franciscoNSoria/Competencia-Robotica-CAID/docs/README.md

# Documentación

| Carpeta | Qué hay |
|---|---|
| [`reglamento/`](reglamento/) | Reglamento general (PDF) y transcripción del desafío "Laberinto inteligente" |
| [`roadmap/`](roadmap/) | El plan de trabajo por columnas, hitos y reglas de merge |
| [`guias/`](guias/) | Cómo hacer cosas: primeros pasos con el repo, entorno de desarrollo y GitHub Projects |
| [`decisiones/`](decisiones/) | Decisiones de arquitectura (ADR): qué decidimos y por qué |
| [`analisis/`](analisis/) | Análisis técnicos de apoyo (por ejemplo, el trabajo previo de navegación) |
| [`memoria/`](memoria/) | La memoria técnica, que se escribe sección por sección durante el proyecto |
