franciscoNSoria/Competencia-Robotica-CAID/docs/decisiones/plantilla.md

# NNNN. Título corto de la decisión

- **Estado:** Propuesta | Aceptada | Reemplazada por NNNN
- **Fecha:** AAAA-MM-DD

## Contexto

¿Qué problema hay que resolver? ¿Qué restricciones hay (reglamento, hardware, tiempo)?

## Decisión

Qué decidimos, en una o dos frases claras.

## Alternativas consideradas

- **Alternativa A:** por qué no.
- **Alternativa B:** por qué no.

## Consecuencias

Qué se vuelve más fácil, qué se vuelve más difícil y qué hay que hacer a partir de ahora.
