franciscoNSoria/Competencia-Robotica-CAID/docs/arquitectura/img/rviz_brazo.png

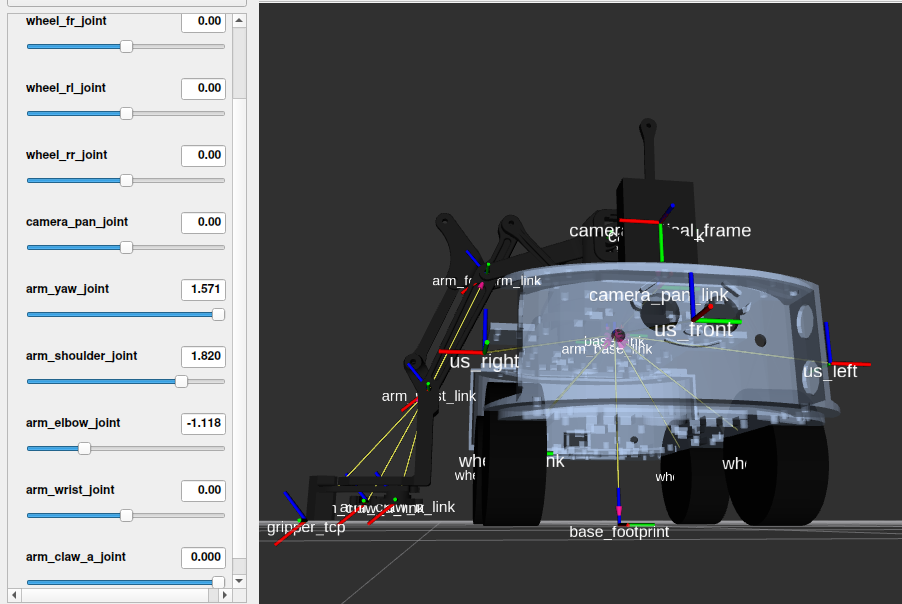
docs/arquitectura/img/rviz_brazo.png
