franciscoNSoria/Competencia-Robotica-CAID/docs/arquitectura/img/rviz_resposo.png

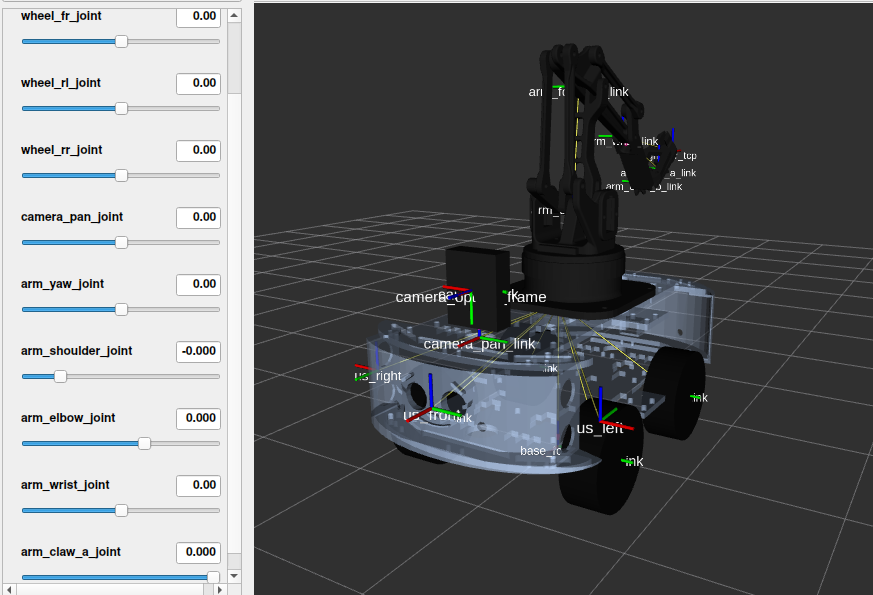
docs/arquitectura/img/rviz_resposo.png
