franciscoNSoria/Competencia-Robotica-CAID/firmware/pruebas/img/circuito_completo_pinout_actual.png

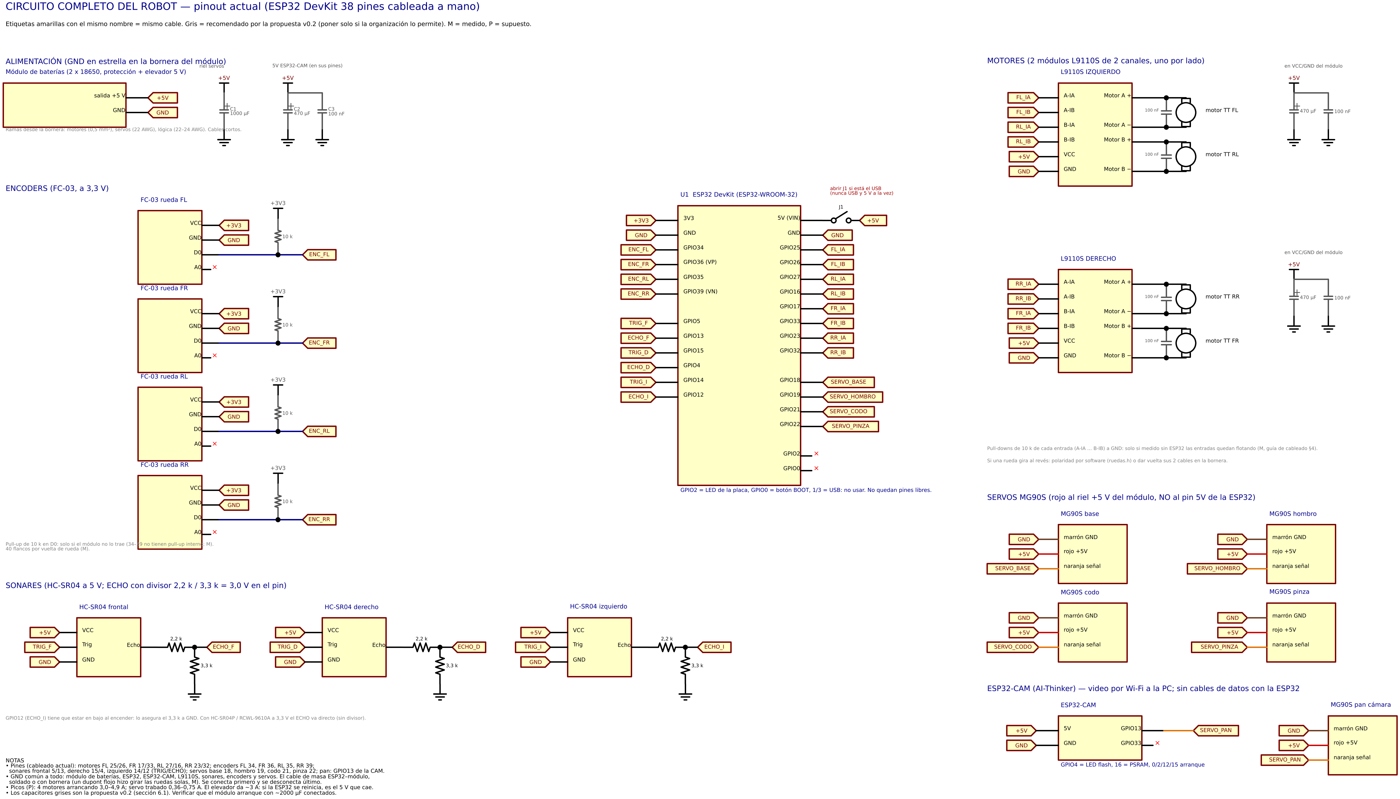
firmware/pruebas/img/circuito_completo_pinout_actual.png
