franciscoNSoria/Competencia-Robotica-CAID/hardware/electronica/placas/ConcentradorDelantero_esquematico_1.png

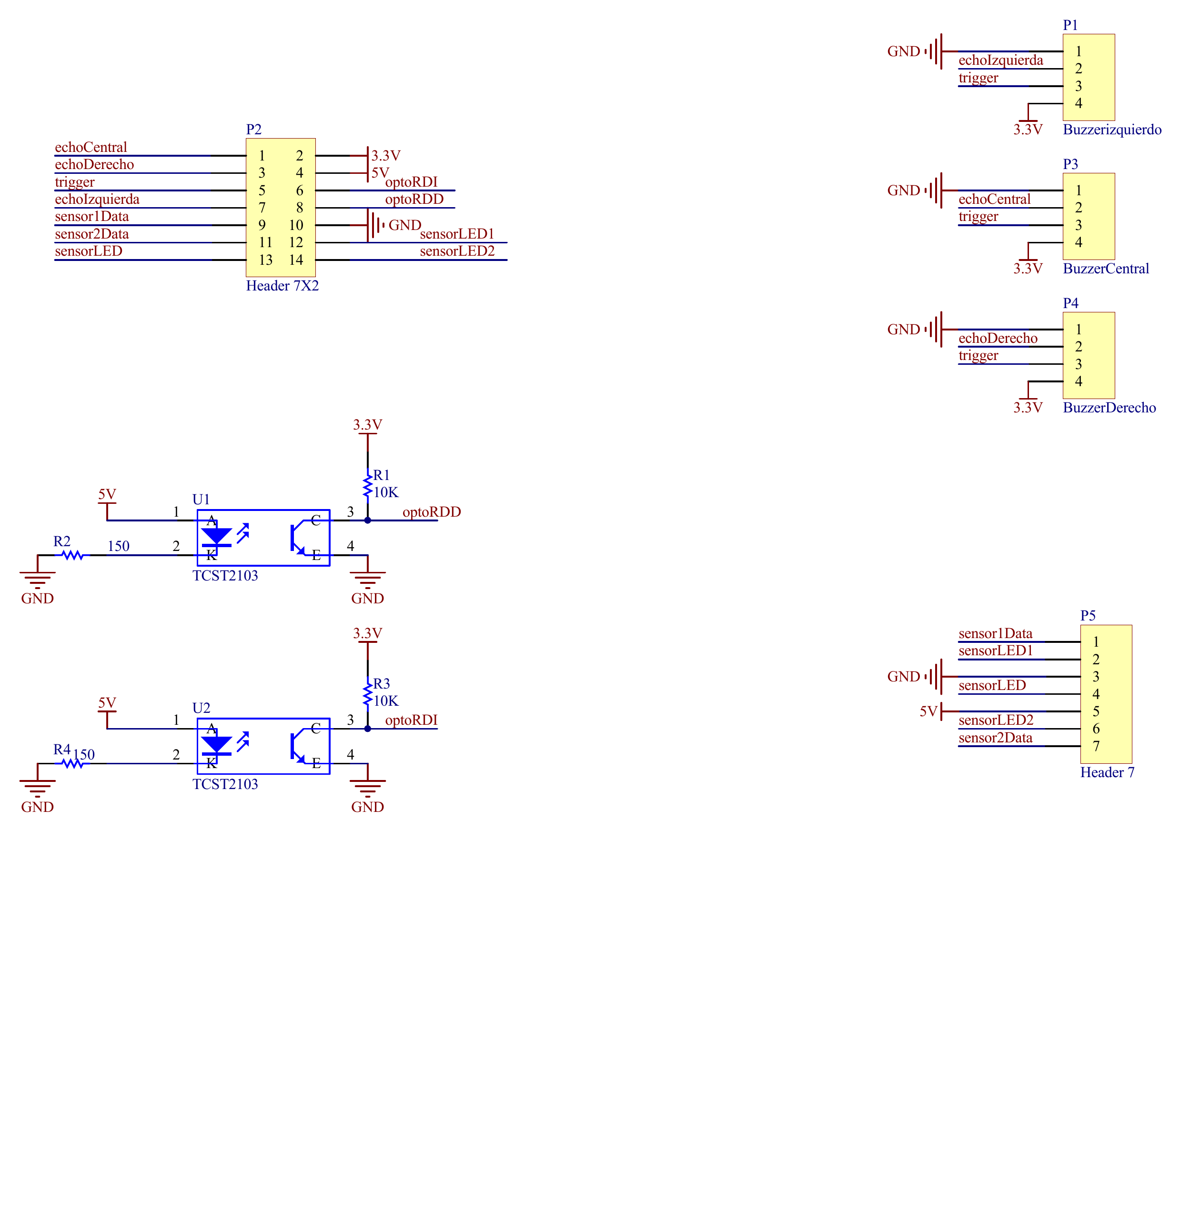
hardware/electronica/placas/ConcentradorDelantero_esquematico_1.png
