franciscoNSoria/Competencia-Robotica-CAID/hardware/electronica/placas/ConcentradorDelantero_pcb.png

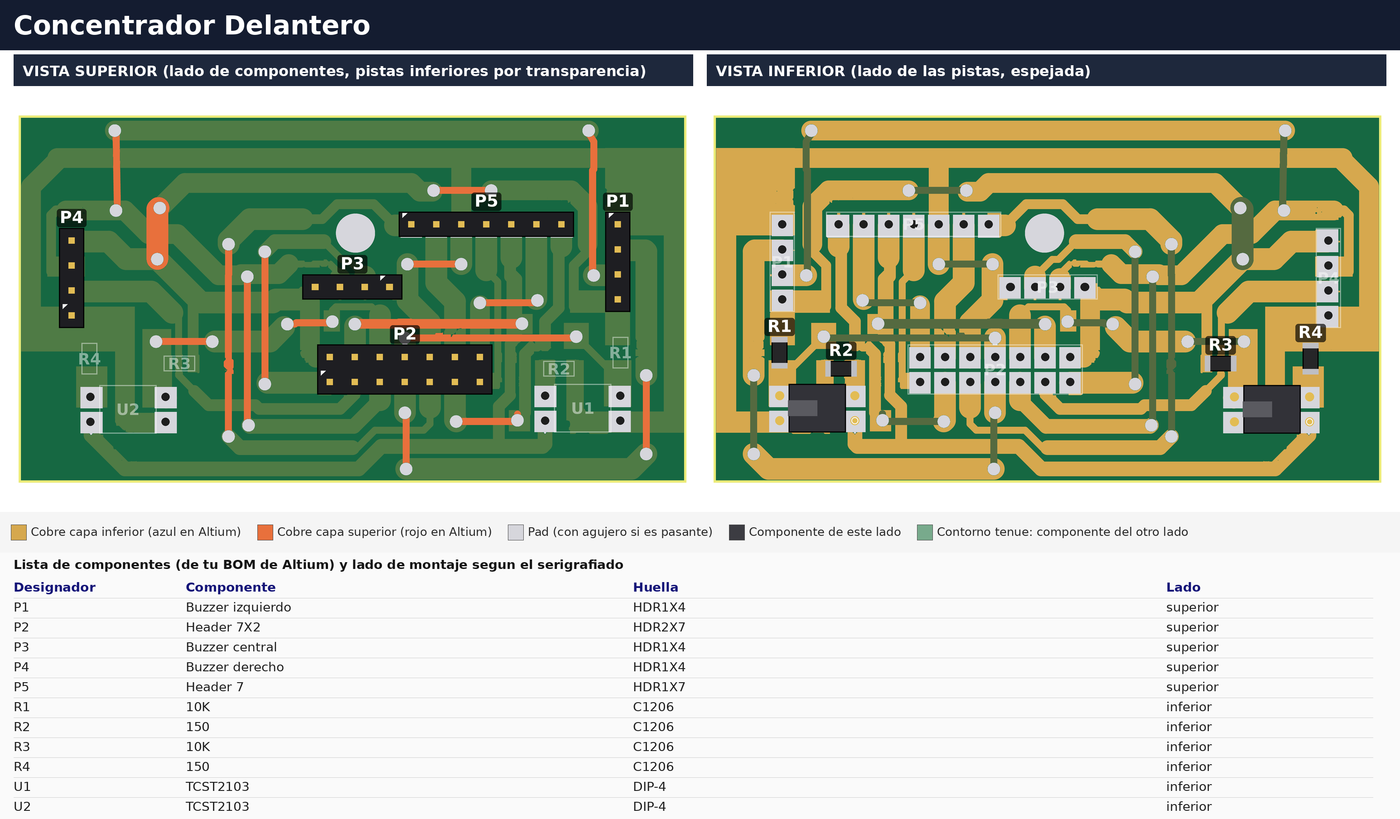
hardware/electronica/placas/ConcentradorDelantero_pcb.png
