franciscoNSoria/Competencia-Robotica-CAID/hardware/electronica/placas/ControlBrazo_esquematico_1.png

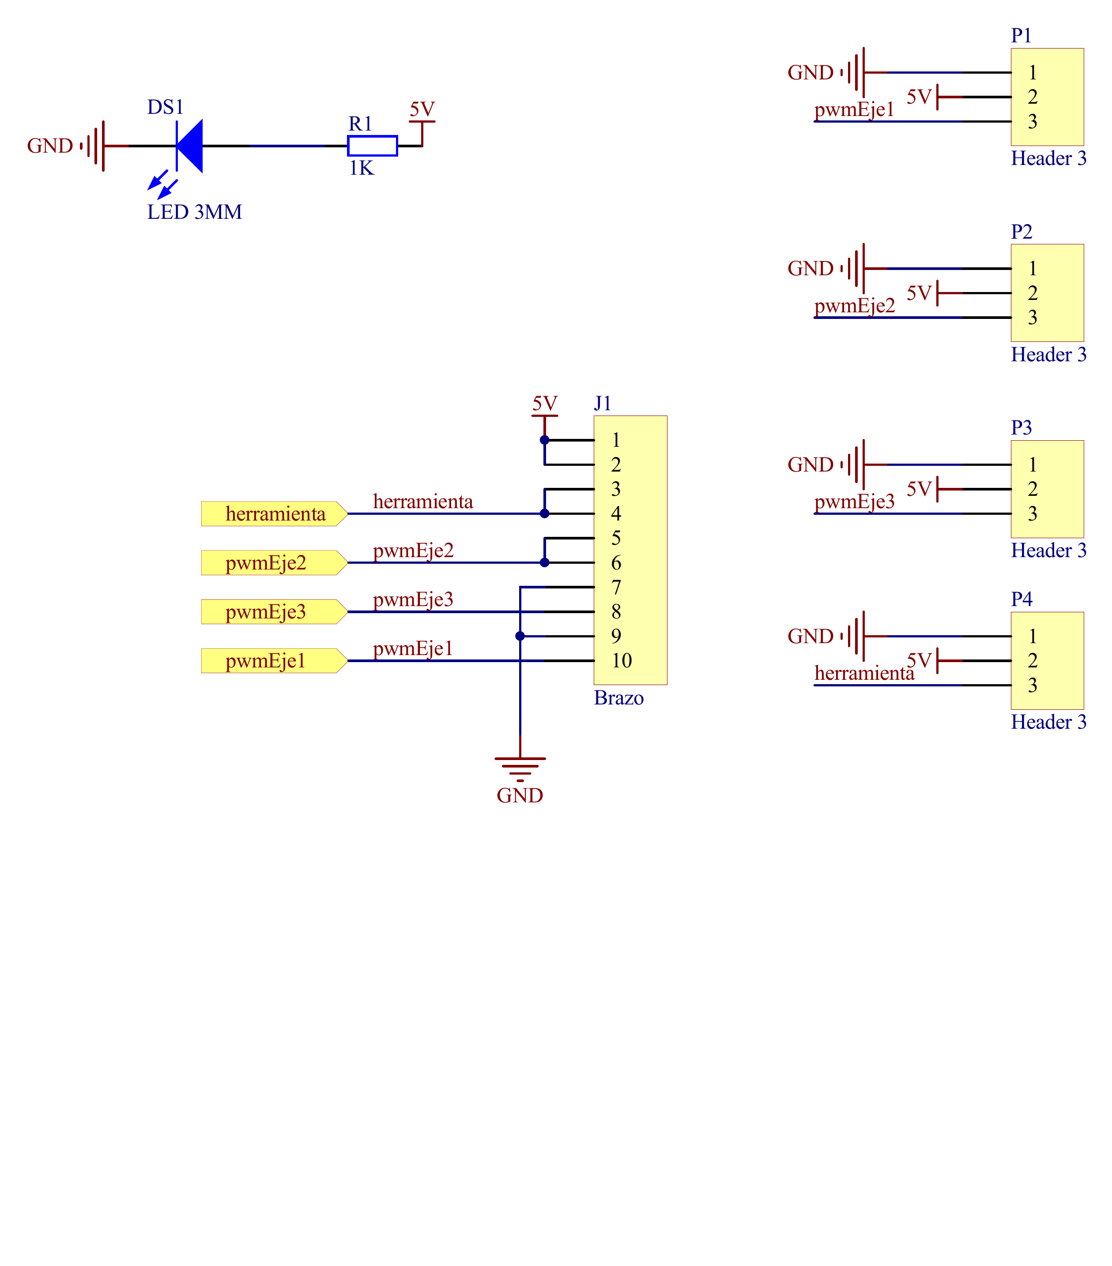
hardware/electronica/placas/ControlBrazo_esquematico_1.png
