franciscoNSoria/Competencia-Robotica-CAID/hardware/electronica/placas/ControlBrazo_pcb.png

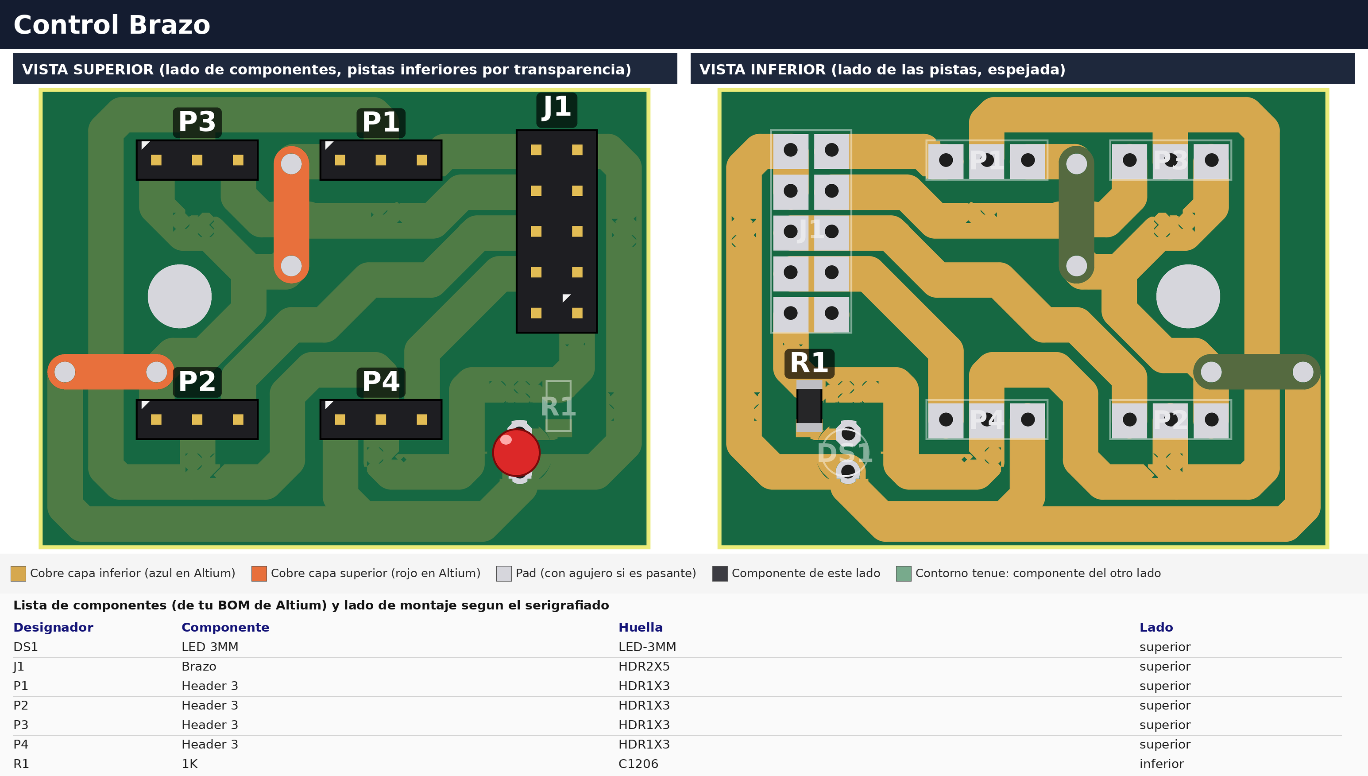
hardware/electronica/placas/ControlBrazo_pcb.png
