franciscoNSoria/Competencia-Robotica-CAID/hardware/electronica/placas/ControlRobot_esquematico_1.png

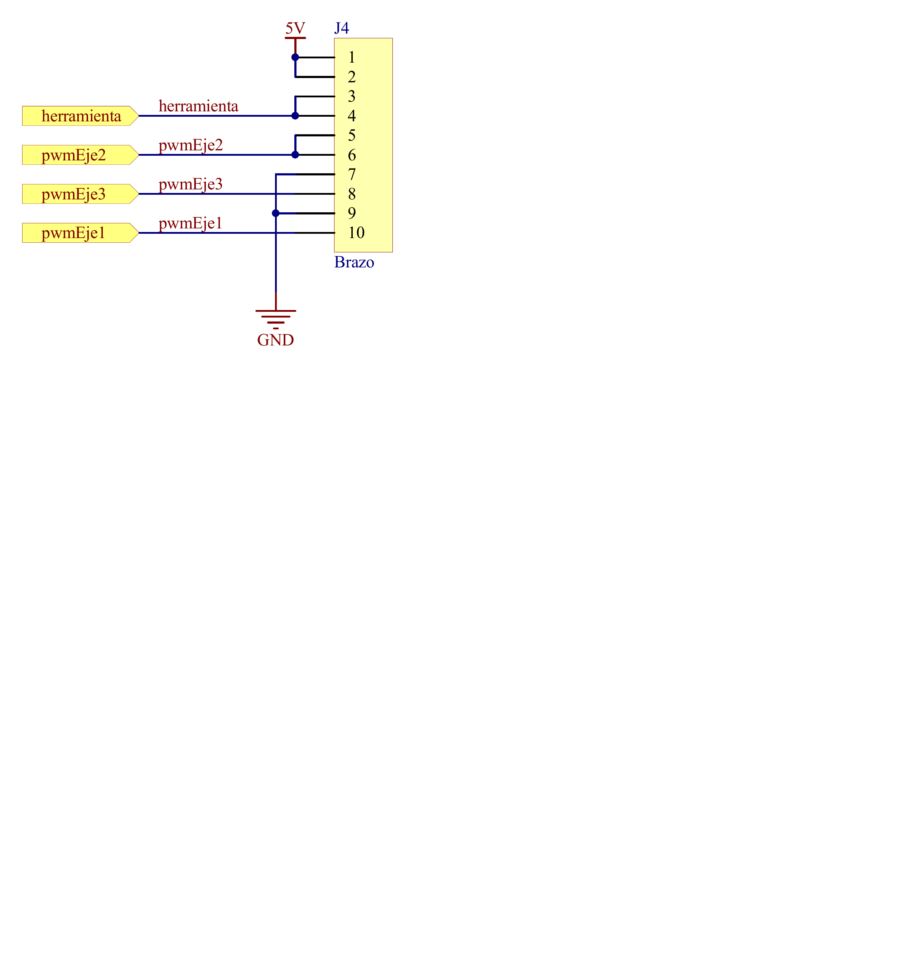
hardware/electronica/placas/ControlRobot_esquematico_1.png
