franciscoNSoria/Competencia-Robotica-CAID/hardware/electronica/placas/ControlRobot_esquematico_2.png

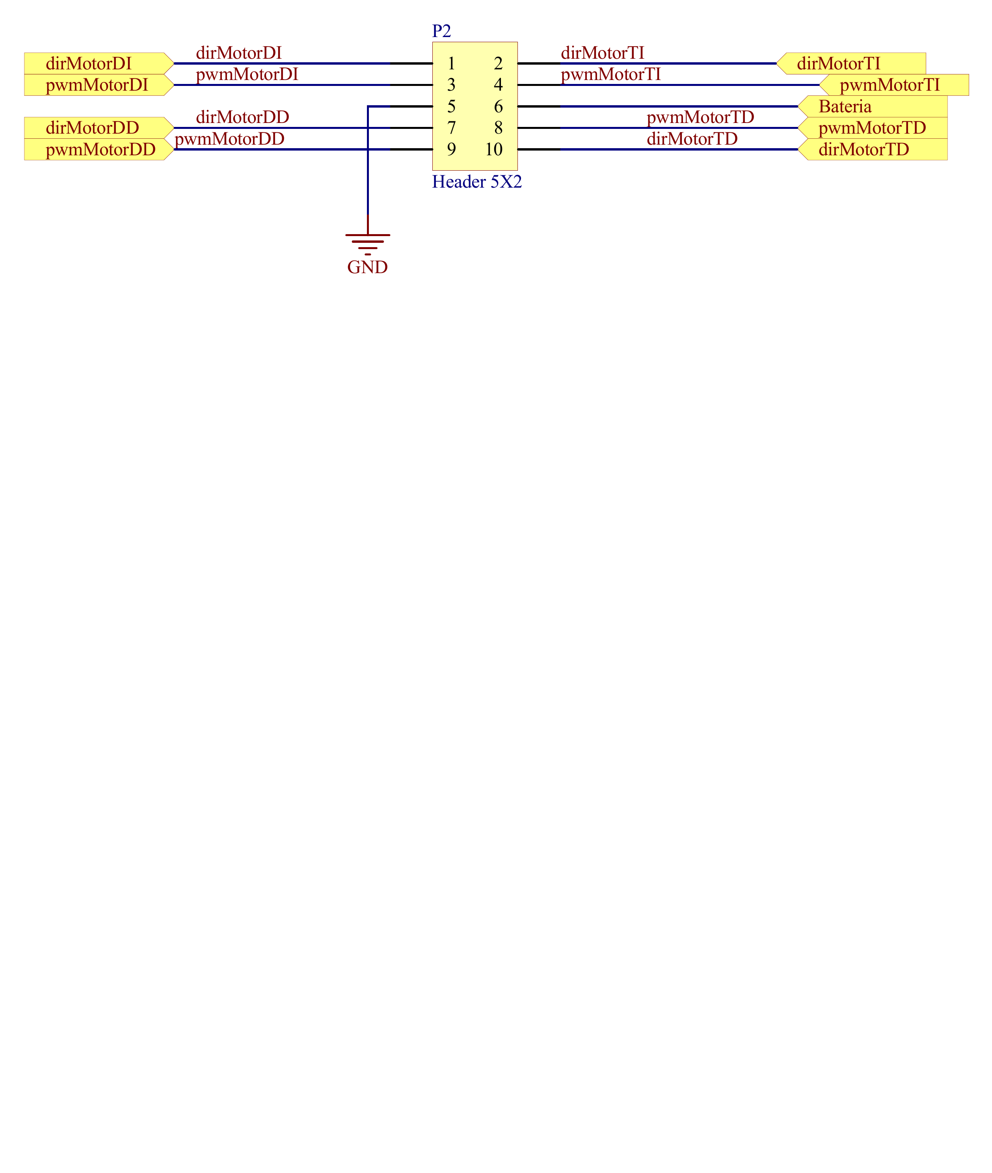
hardware/electronica/placas/ControlRobot_esquematico_2.png
