franciscoNSoria/Competencia-Robotica-CAID/hardware/electronica/placas/ControlRobot_esquematico_3.png

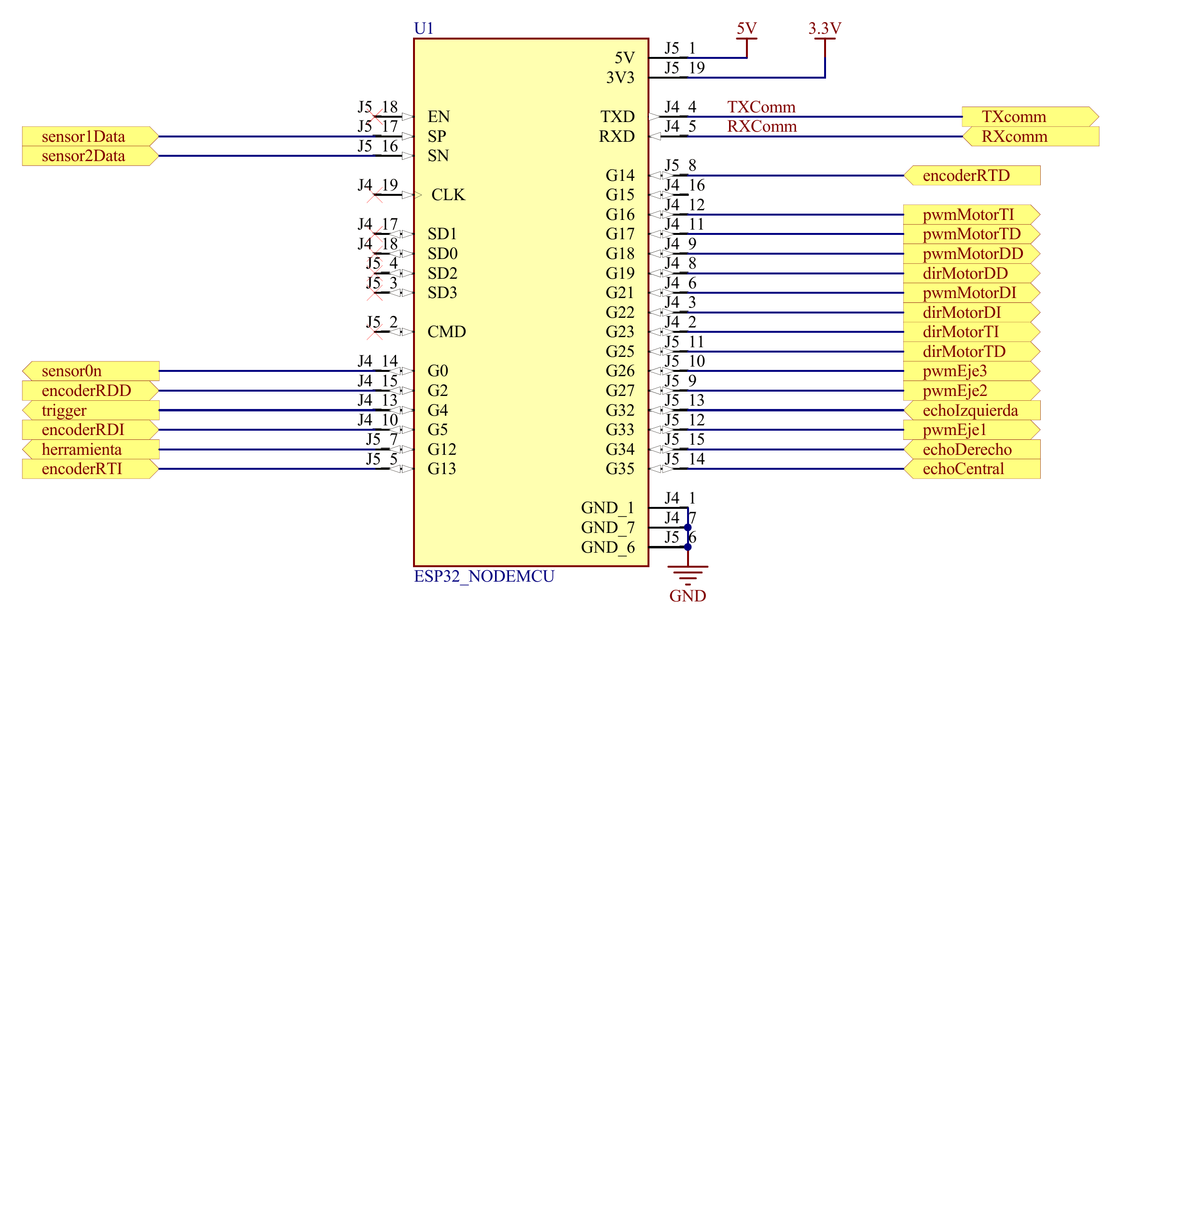
hardware/electronica/placas/ControlRobot_esquematico_3.png
