franciscoNSoria/Competencia-Robotica-CAID/hardware/electronica/placas/ControlRobot_esquematico_4.png

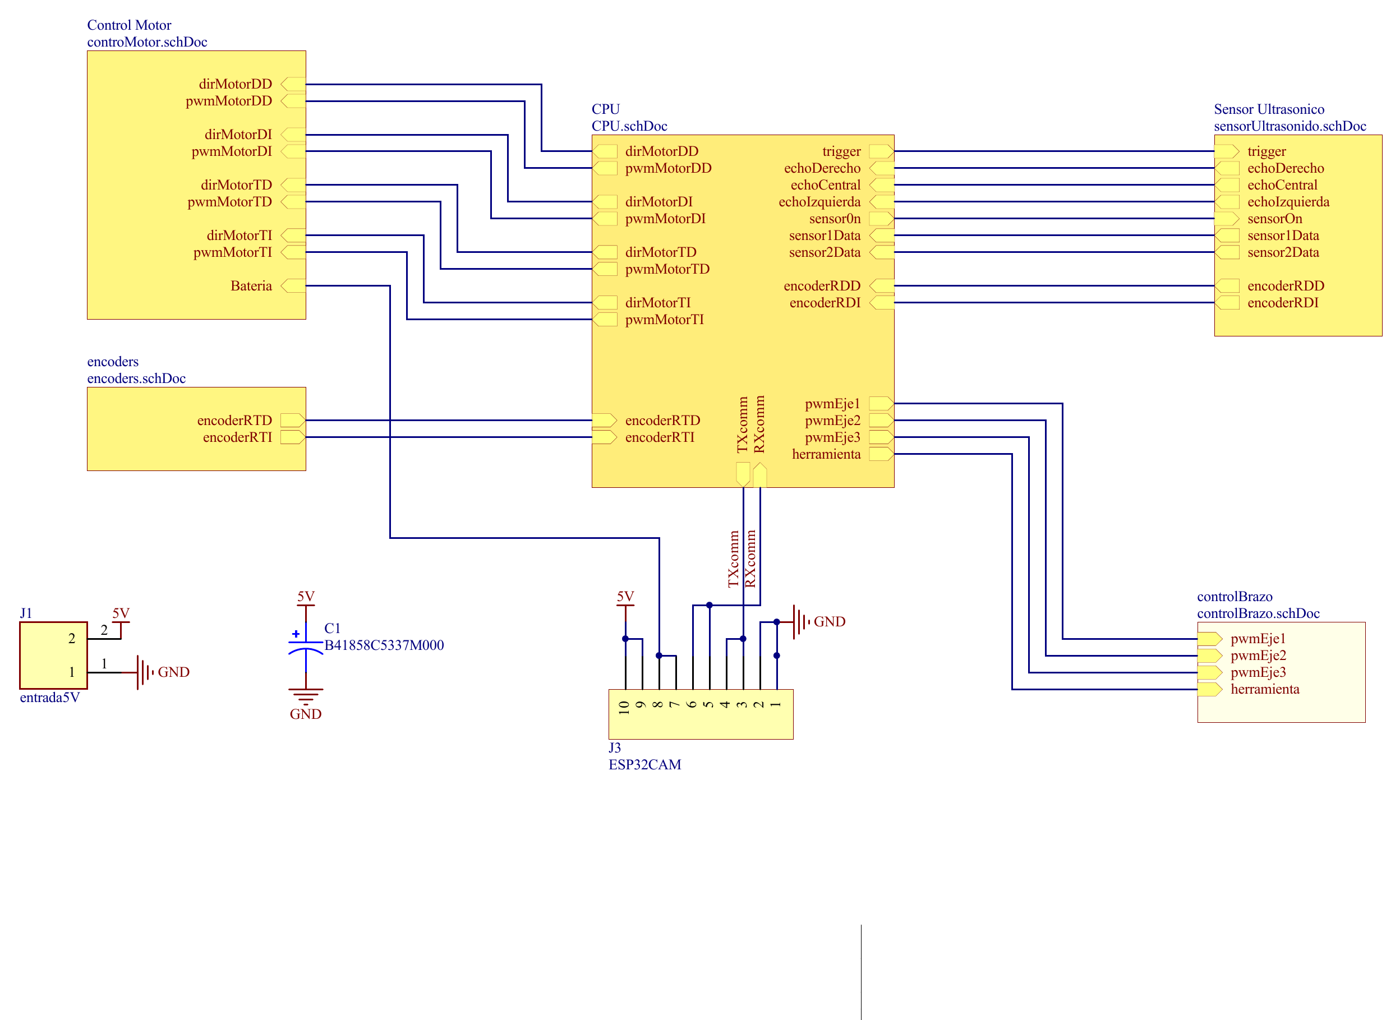
hardware/electronica/placas/ControlRobot_esquematico_4.png
