franciscoNSoria/Competencia-Robotica-CAID/hardware/electronica/placas/ControlRobot_esquematico_5.png

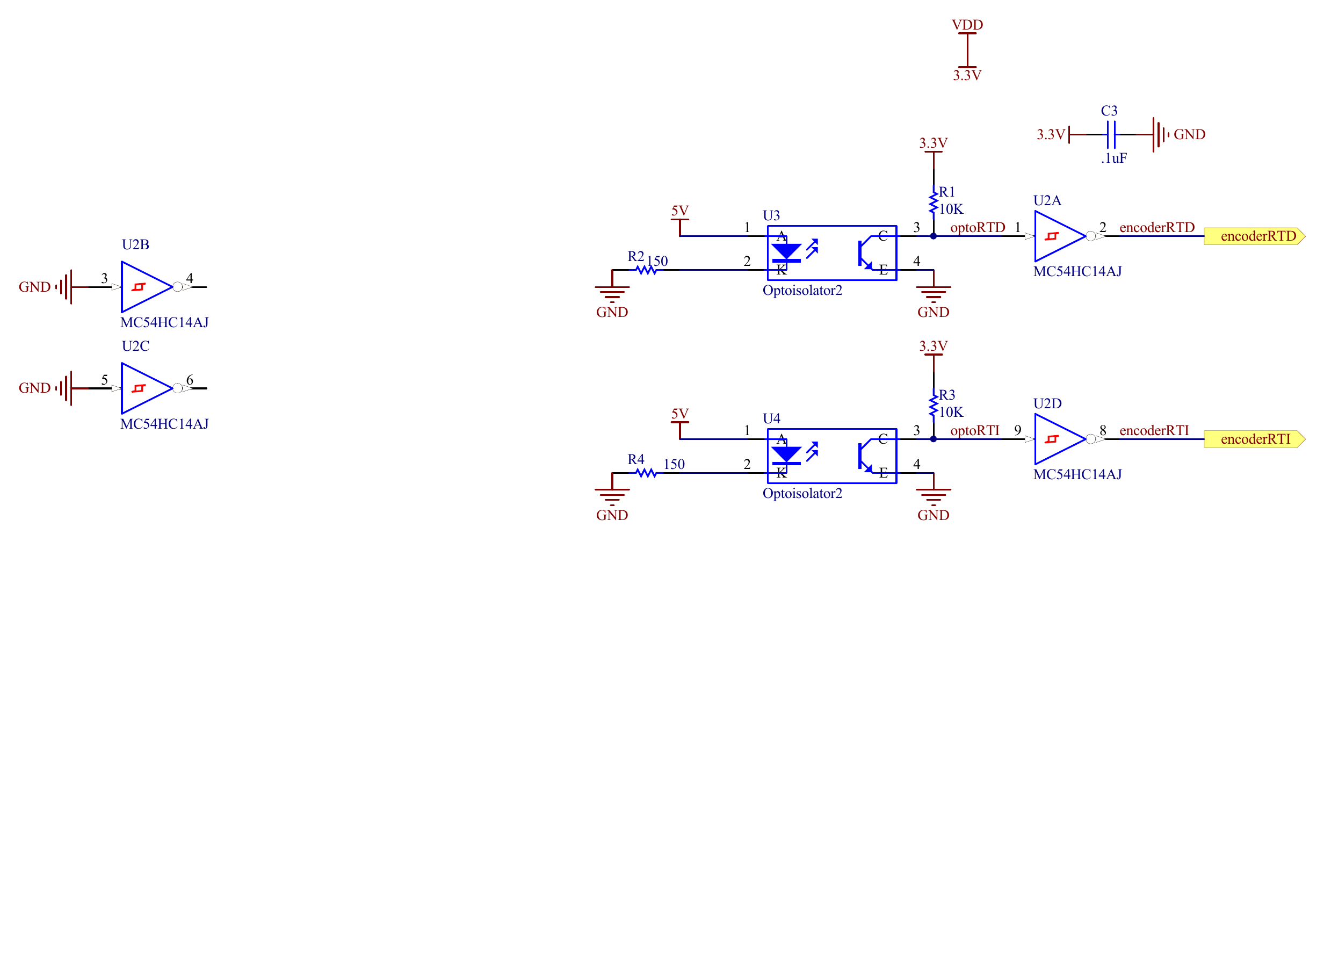
hardware/electronica/placas/ControlRobot_esquematico_5.png
