franciscoNSoria/Competencia-Robotica-CAID/hardware/electronica/placas/ControlRobot_esquematico_6.png

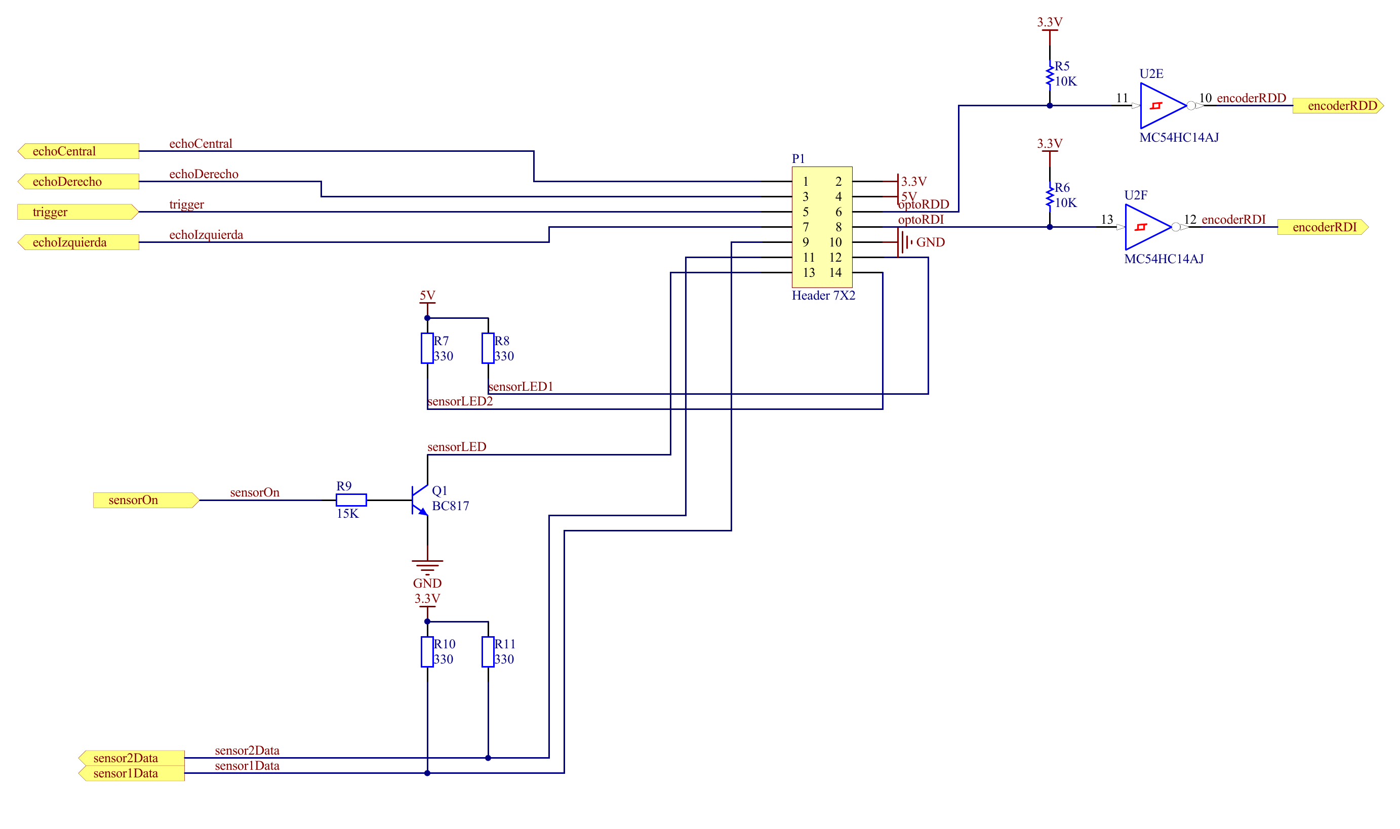
hardware/electronica/placas/ControlRobot_esquematico_6.png
