franciscoNSoria/Competencia-Robotica-CAID/hardware/electronica/placas/ControlRobot_pcb.png

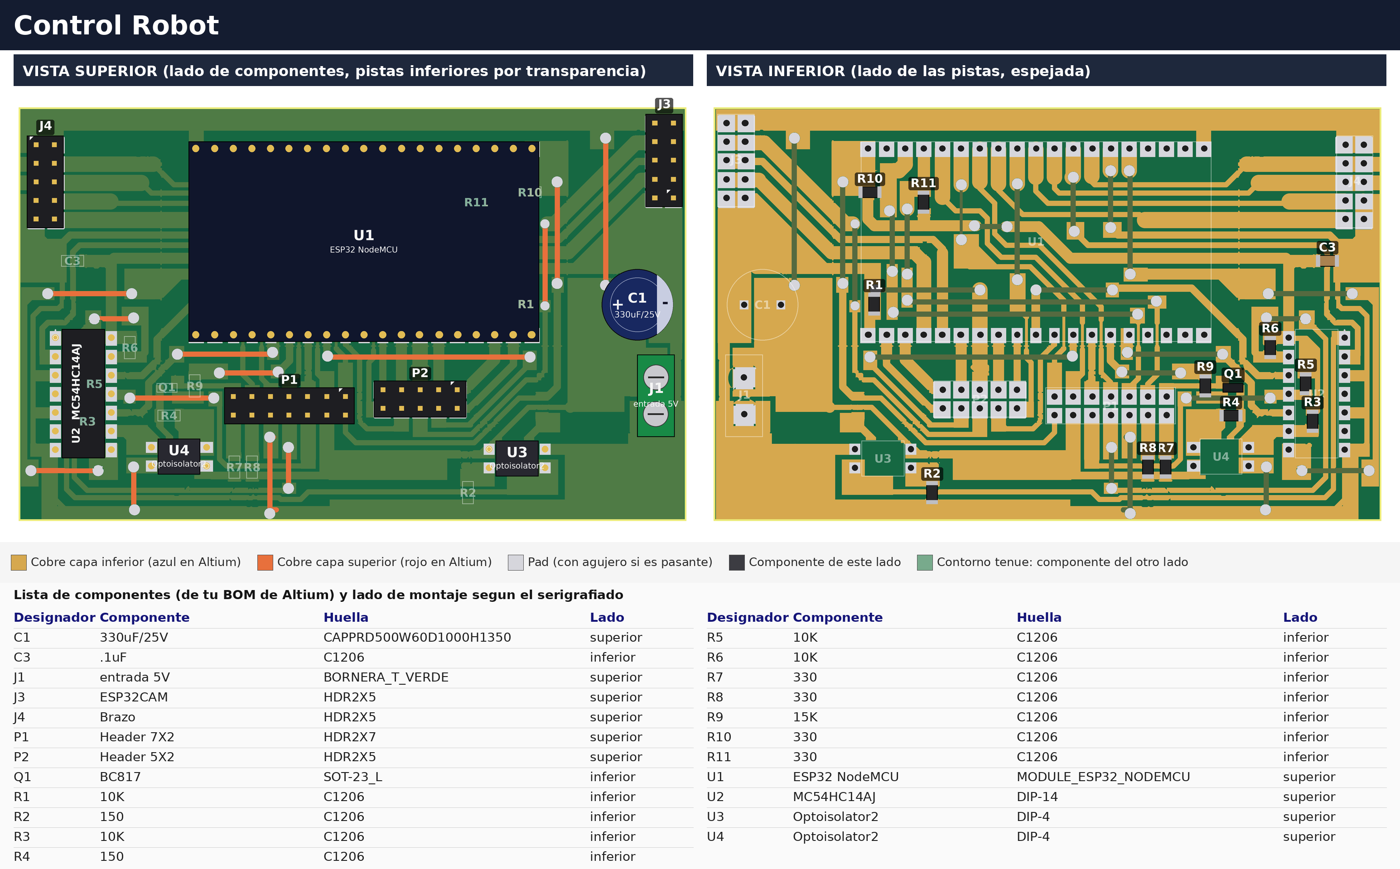
hardware/electronica/placas/ControlRobot_pcb.png
