franciscoNSoria/Competencia-Robotica-CAID/hardware/electronica/placas/ESP32CAM_esquematico_1.png

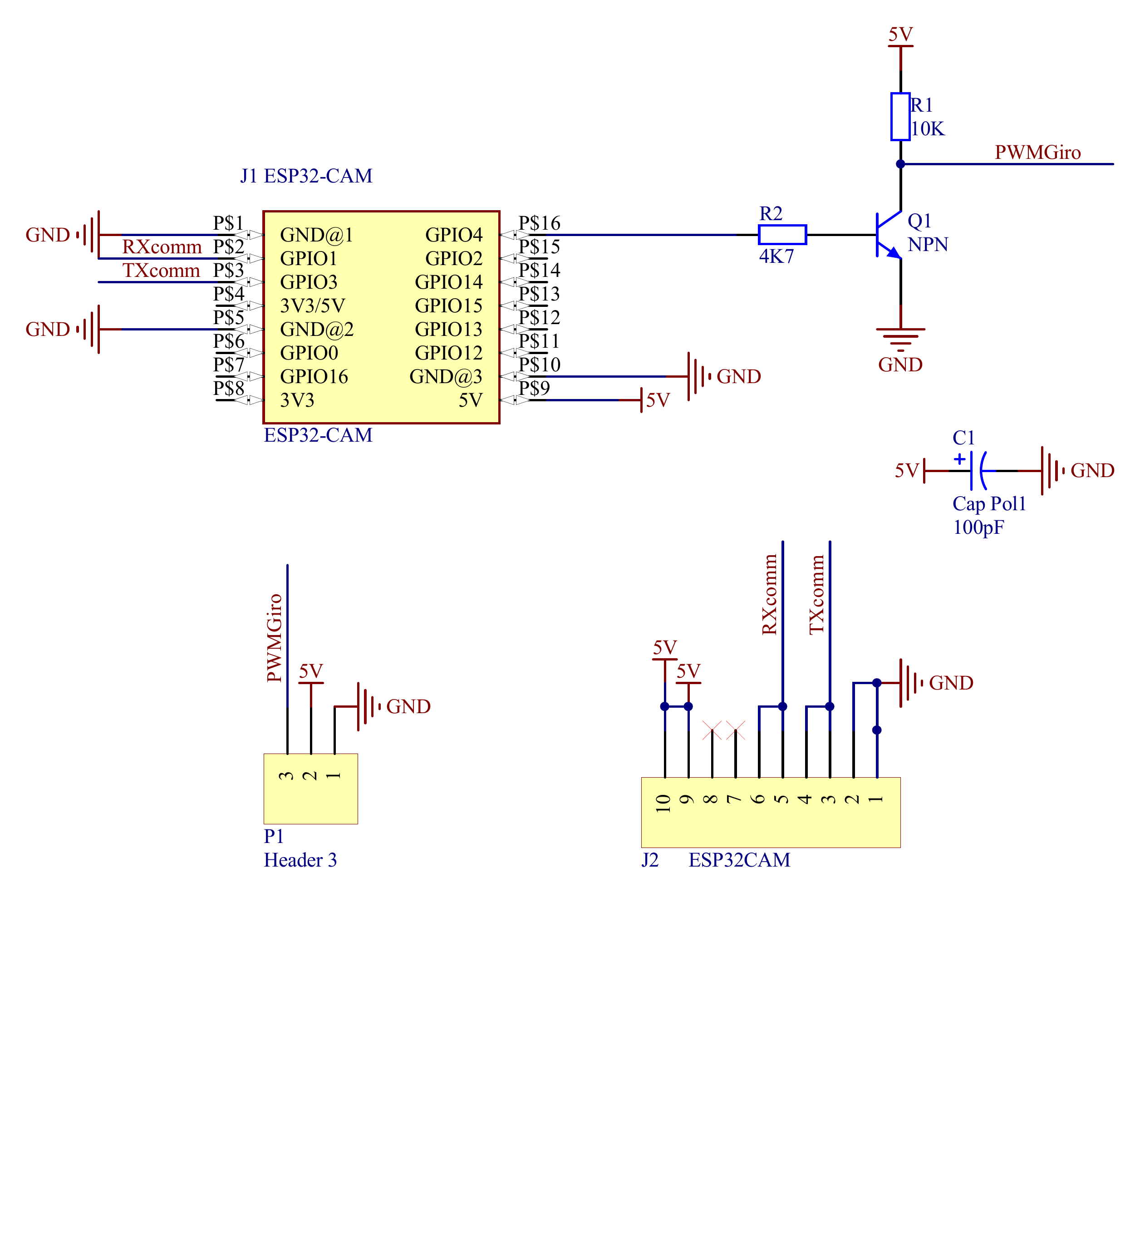
hardware/electronica/placas/ESP32CAM_esquematico_1.png
