franciscoNSoria/Competencia-Robotica-CAID/hardware/electronica/placas/ESP32CAM_pcb.png

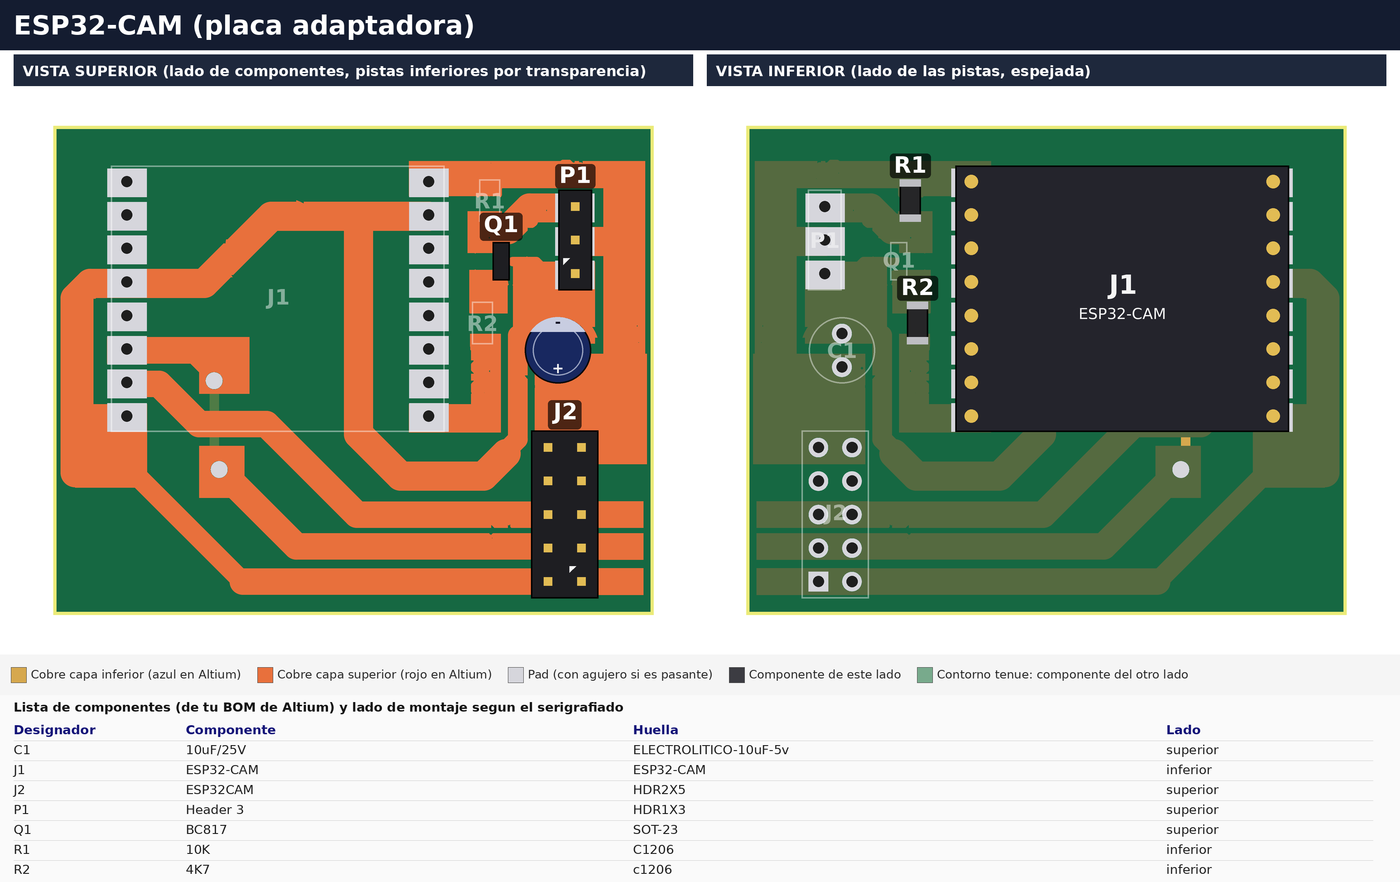
hardware/electronica/placas/ESP32CAM_pcb.png
