franciscoNSoria/Competencia-Robotica-CAID/hardware/electronica/placas/esquema_alimentacion_2S.png

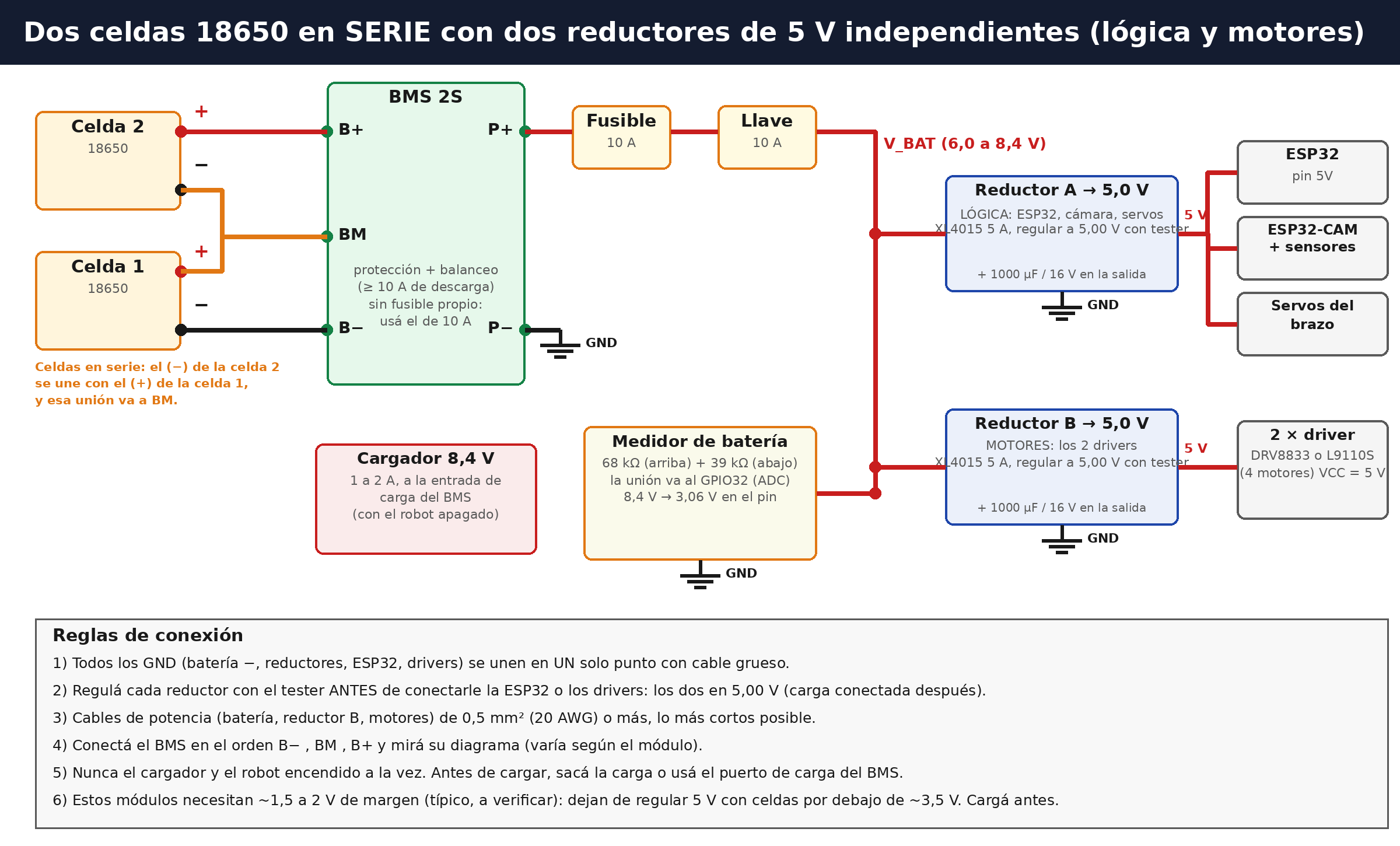
hardware/electronica/placas/esquema_alimentacion_2S.png
