franciscoNSoria/Competencia-Robotica-CAID/hardware/electronica/placas/PlacaMotor_esquematico_1.png

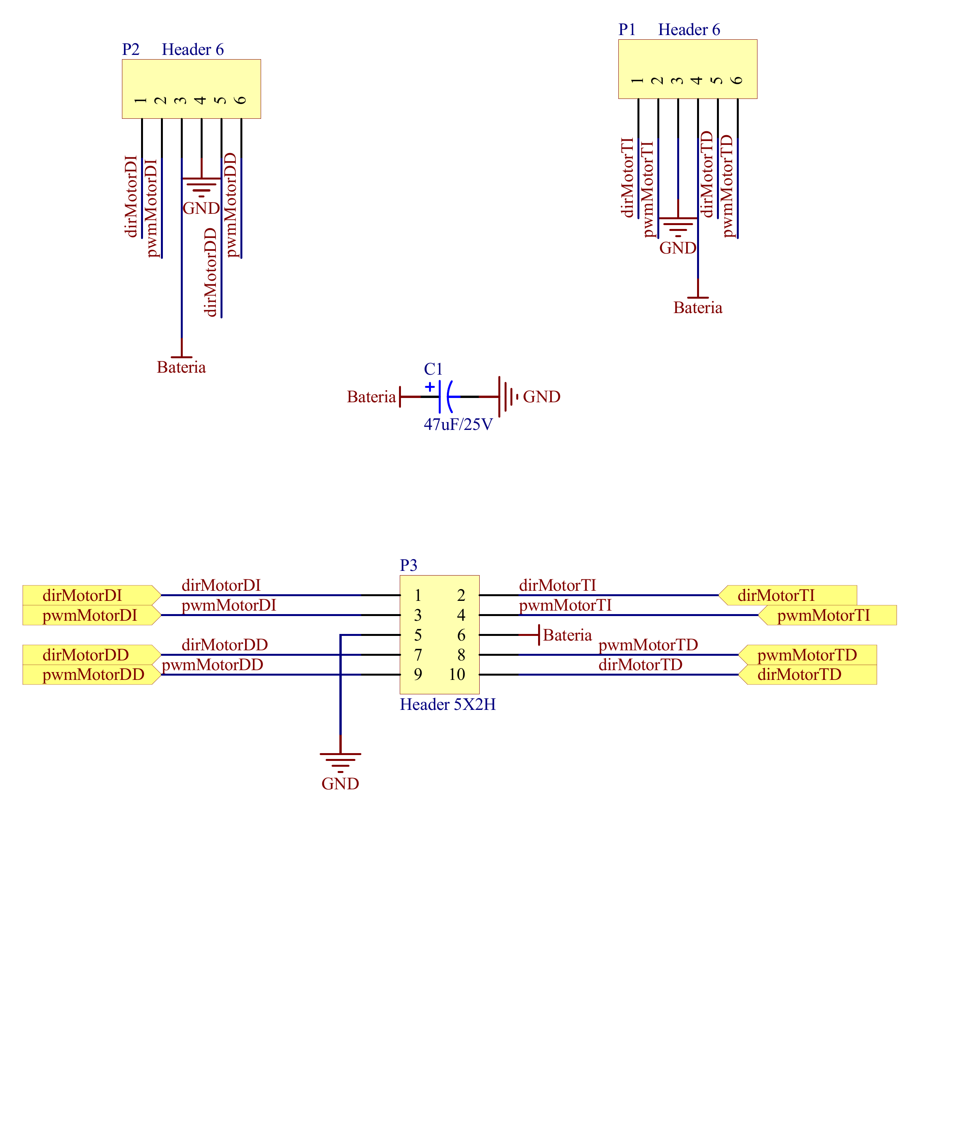
hardware/electronica/placas/PlacaMotor_esquematico_1.png
