franciscoNSoria/Competencia-Robotica-CAID/hardware/electronica/placas/PlacaMotor_pcb.png

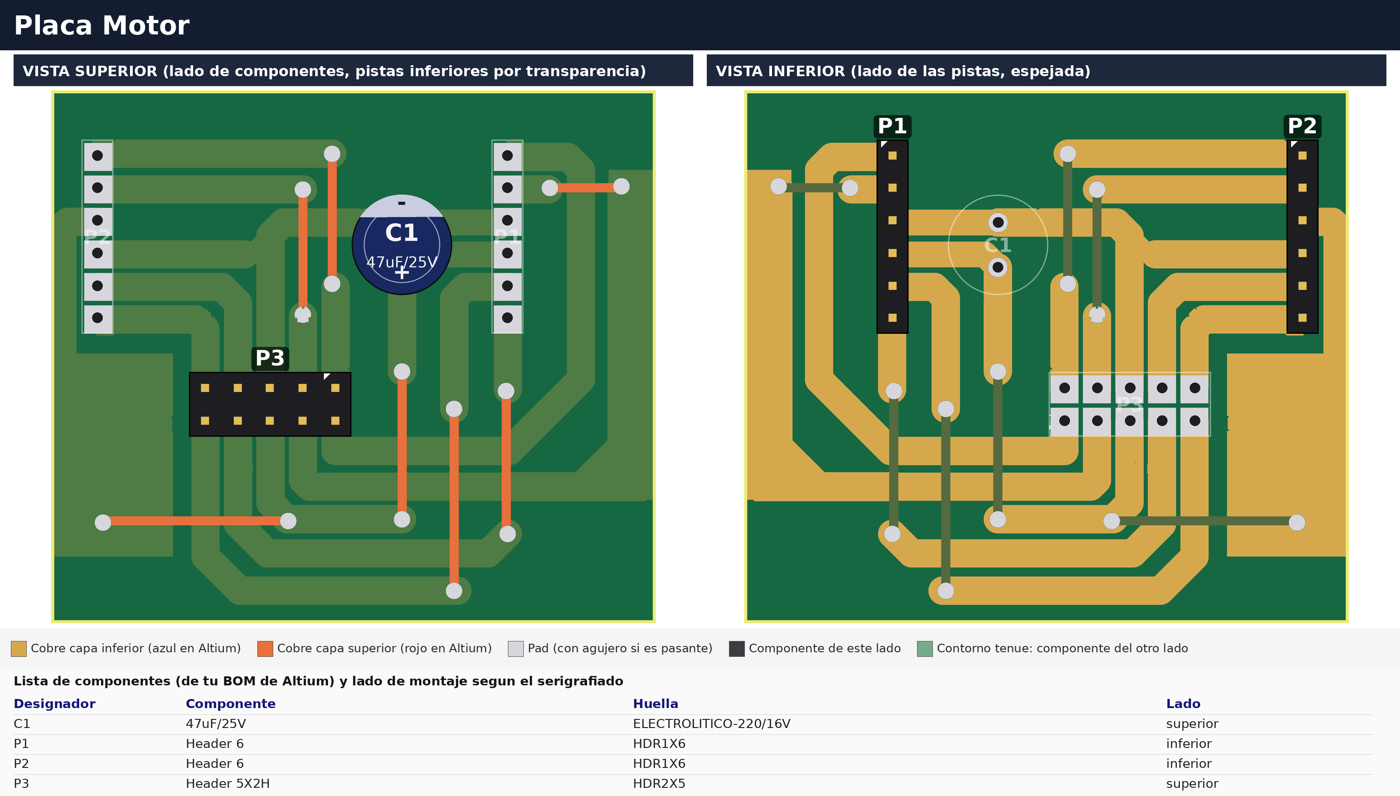
hardware/electronica/placas/PlacaMotor_pcb.png
