franciscoNSoria/Competencia-Robotica-CAID/hardware/bom/Lista_de_partes.ods

Conjunto | Subconjunto | Pieza | Descripción | Código | Cantidad | Peso unitario (g)
 |  |  |  |  |  |  | Codificación
Armadillo | Brazo |  | Base | ARM2-CUDAR-0-1-10 | 1 | 40 | Prefijo | Conjunto | Subconjunto | Numero de piezas
 |  |  |  |  |  |  | ARM2-CUDAR- | 0 Armadillo | 1 brazo | 10
 |  |  |  |  |  |  |  |  | 2 chasis | 10
 |  |  |  |  |  |  |  |  | 3 cámara | 4
 |  |  |  |  |  |  | ELEMENTOS |  | Cantidad
 |  |  |  |  |  |  | TORNILLOS | M3 x 40 | 1
 |  |  |  |  |  |  |  | M3 x 30 | 2
 |  |  |  |  |  |  |  | M3 x 25 | 11
 |  |  | Engranaje conductor | ARM2-CUDAR-0-1-20 | 1 | 1 |  | M3 x 20 | 10
 |  |  |  |  |  |  |  | M3 x 15 | 4
 |  |  |  |  |  |  | TUERCAS | M3 | 28
 |  |  |  |  |  |  | CHASIS | 4WD | 2
 |  |  |  |  |  |  | MOTOR-RUEDA | 4WD | 4
 |  |  |  |  |  |  | SERVOS | SG90 | 5
 |  |  | Soporte de garras | ARM2-CUDAR-0-1-30 | 1 | 11
 |  |  | Engranaje conducido | ARM2-CUDAR-0-1-40 | 1 | 1
 |  |  | Garra izquierda | ARM2-CUDAR-0-1-50 | 1 | 3
 |  |  | Garra derecha | ARM2-CUDAR-0-1-60 | 1 | 3
 |  |  | Brazo principal | ARM2-CUDAR-0-1-70 | 1 | 10
 |  |  | soporte de servo | ARM2-CUDAR-0-1-80 | 2 | 1
 |  |  | Soporte triangular | ARM2-CUDAR-0-1-90 | 1 | 4
 |  |  | Brazo superior | ARM2-CUDAR-0-1-100 | 1 | 7
 |  |  | Articulación | ARM2-CUDAR-0-1-110 | 3 | 3
 |  |  | Soporte principal | ARM2-CUDAR-0-1-120 | 1 | 19
 |  |  | Plato circular | ARM2-CUDAR-0-1-130 | 1 | 14
 |  |  | Brazo para servo | ARM2-CUDAR-0-1-140 | 1 | 3
 |  |  | Arandela de separación | ARM2-CUDAR-0-150 | 1 | 15
 | Chasis |  | Frente | ARM2-CUDAR-0-2-10 | 1 | 45
 |  |  | Posterior | ARM2-CUDAR-0-2-20 | 1 | 50
 |  |  | Lateral | ARM2-CUDAR-0-2-30 | 2 | 8
 |  |  | Tapa superior | ARM2-CUDAR-0-2-40 | 1 | 8
 |  |  | Tapas inferiores/superior trasera | ARM2-CUDAR-0-2-50 | 3 | 33
 |  |  | Soporte motores | ARM2-CUDAR-0-2-60 | 2 | 28
 | Cámara |  | Caja cámara frente | ARM2-CUDAR-0-3-10 | 1 | 5
 |  |  | Caja cámara posterior | ARM2-CUDAR-0-3-20 | 1 | 4
 |  |  | Unión cámara servo | ARM2-CUDAR-0-3-30 | 1 | 6
 |  |  | Soporte servo | ARM2-CUDAR-0-3-40 | 1 | 5
