franciscoNSoria/Competencia-Robotica-CAID/hardware/cad/ensamblado/Robot_armadillo_armado.stl

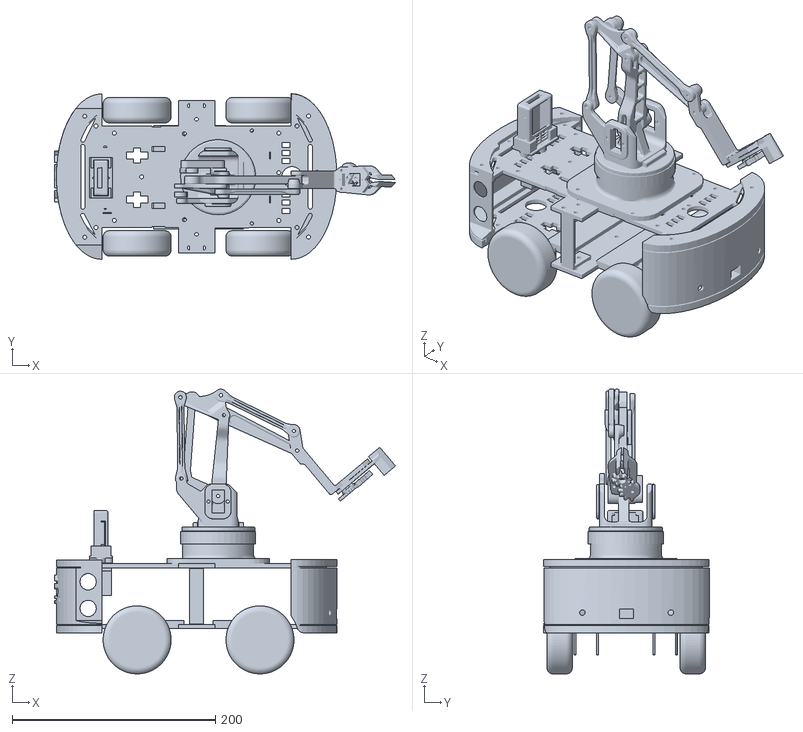
[picture p20: CAD file, 2026-10-19]
hardware/cad/ensamblado/Robot_armadillo_armado.stl
335.8 x 163.2 x 280.4
