franciscoNSoria/Competencia-Robotica-CAID/hardware/cad/Subconjunto-1-brazo/ARM2-CUDAR-0-1-140 Brazo principal.SLDPRT

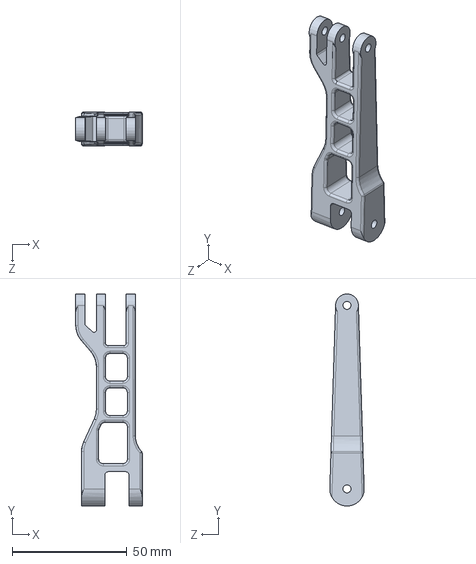
[picture p21: CAD file, 2026-10-15]
hardware/cad/Subconjunto-1-brazo/ARM2-CUDAR-0-1-140 Brazo principal.SLDPRT
29.0 x 92.4 x 15.0 mm
