franciscoNSoria/Competencia-Robotica-CAID/hardware/cad/Subconjunto-2-chasis/ARM2-CUDAR-0-2-10 .SLDPRT

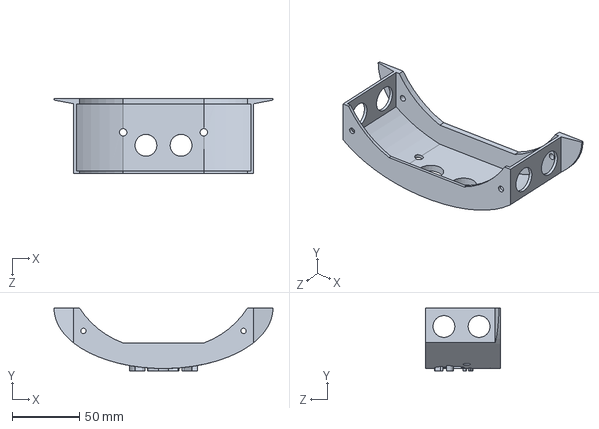
[picture p22: CAD file, 2026-10-15]
hardware/cad/Subconjunto-2-chasis/ARM2-CUDAR-0-2-10 .SLDPRT
163.0 x 46.9 x 56.0 mm
