franciscoNSoria/Competencia-Robotica-CAID/hardware/cad/Subconjunto-3-camara/ARM2-CUDAR-0-3-10.SLDPRT

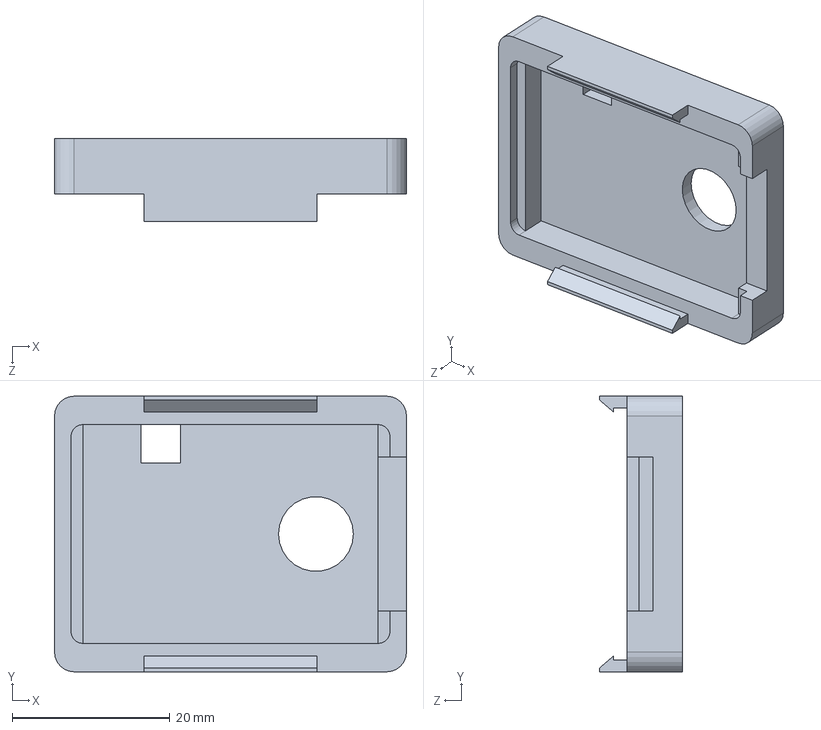
[picture p23: CAD file, 2026-10-15]
hardware/cad/Subconjunto-3-camara/ARM2-CUDAR-0-3-10.SLDPRT
44.7 x 35.0 x 10.5 mm
