franciscoNSoria/Competencia-Robotica-CAID/hardware/stl/Bloque de pared reglamentario.stl

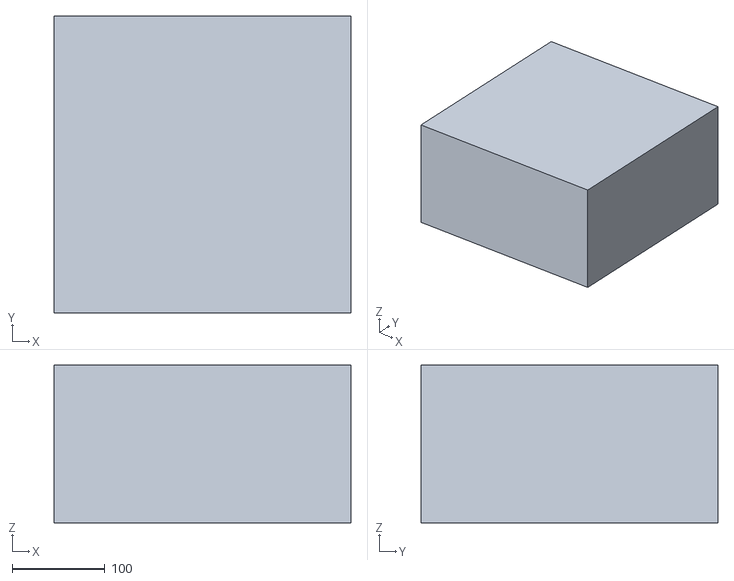
[picture p24: CAD file, 2026-10-28]
hardware/stl/Bloque de pared reglamentario.stl
320.0 x 320.0 x 170.0
