franciscoNSoria/Competencia-Robotica-CAID/ros2_ws/src/caid_description/meshes/arm/arm_wrist.stl

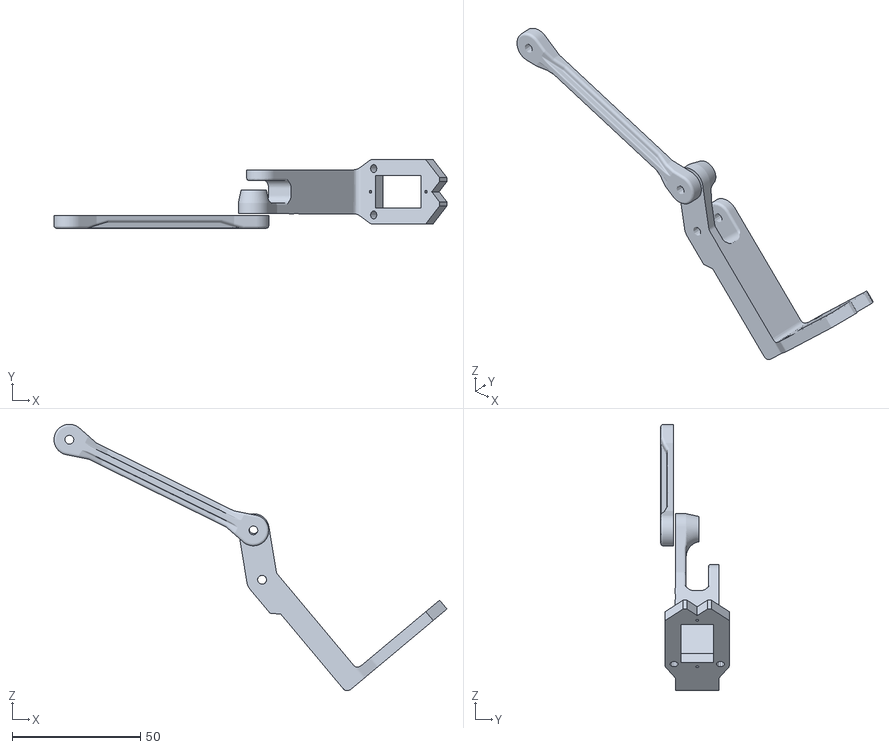
[picture p25: CAD file, 2026-10-19]
ros2_ws/src/caid_description/meshes/arm/arm_wrist.stl
153.2 x 26.7 x 103.9
