franciscoNSoria/Competencia-Robotica-CAID/ros2_ws/src/caid_description/meshes/pared_posterior.stl

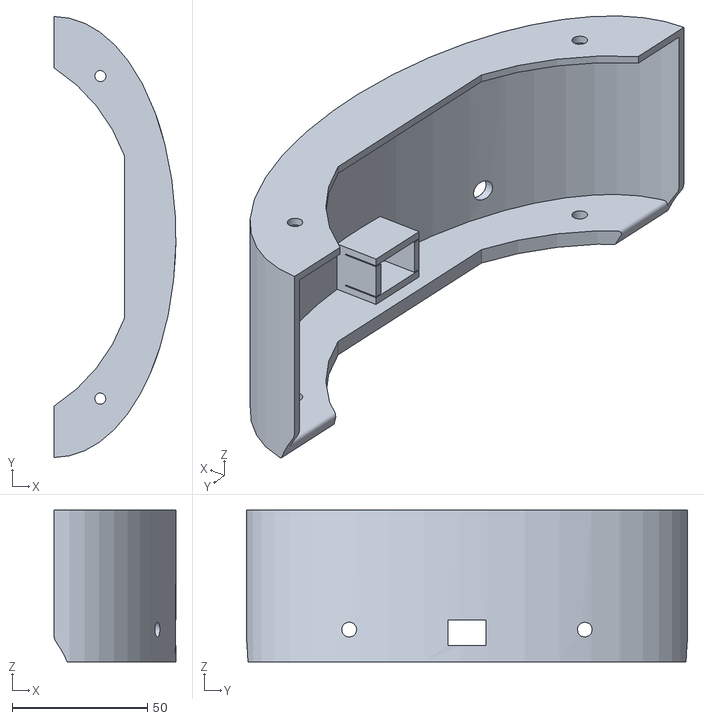
[picture p26: CAD file, 2026-10-19]
ros2_ws/src/caid_description/meshes/pared_posterior.stl
45.0 x 163.0 x 56.0
