franciscoNSoria/Competencia-Robotica-CAID/hardware/cad/Subconjunto-1-brazo/ARM2-CUDAR-0-1-80 Soporte de servo.SLDPRT

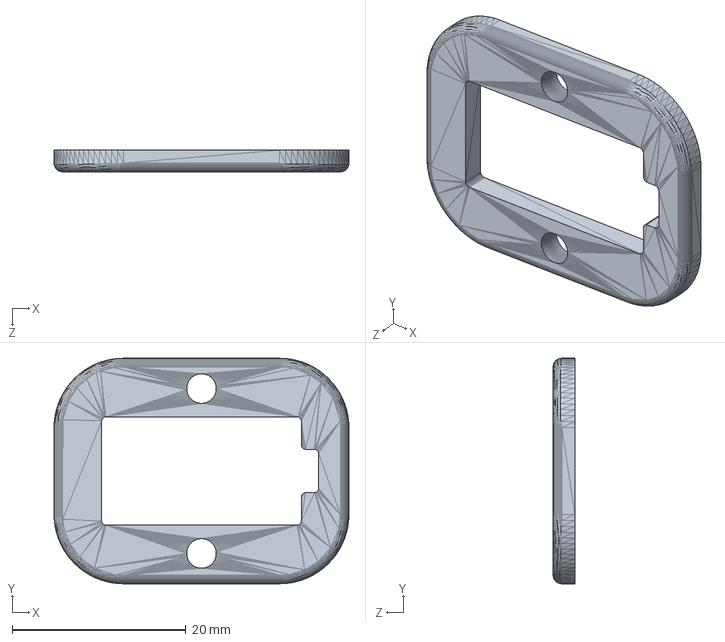
[picture p27: CAD file, 2026-10-15]
hardware/cad/Subconjunto-1-brazo/ARM2-CUDAR-0-1-80 Soporte de servo.SLDPRT
34.0 x 26.0 x 2.50 mm
