franciscoNSoria/Competencia-Robotica-CAID/hardware/cad/Subconjunto-2-chasis/ARM2-CUDAR-0-2-50.SLDPRT

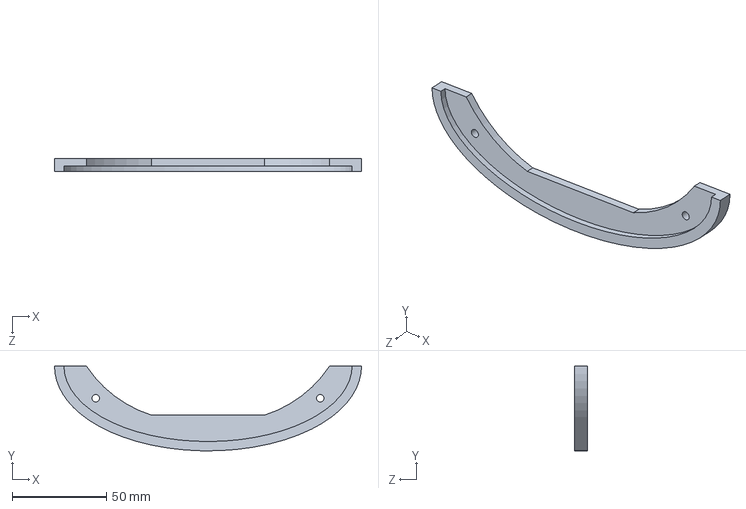
[picture p28: CAD file, 2026-10-15]
hardware/cad/Subconjunto-2-chasis/ARM2-CUDAR-0-2-50.SLDPRT
163.0 x 45.0 x 7.00 mm
