franciscoNSoria/Competencia-Robotica-CAID/hardware/cad/Subconjunto-3-camara/ARM2-CUDAR-0-3-40.SLDPRT

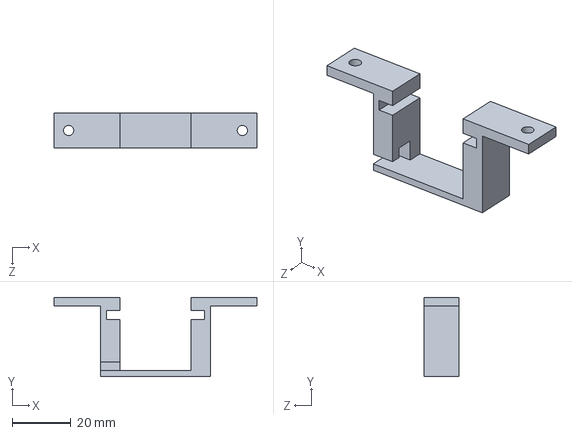
[picture p29: CAD file, 2026-10-15]
hardware/cad/Subconjunto-3-camara/ARM2-CUDAR-0-3-40.SLDPRT
69.2 x 27.0 x 12.0 mm
