franciscoNSoria/Competencia-Robotica-CAID/hardware/stl/Flecha media.stl

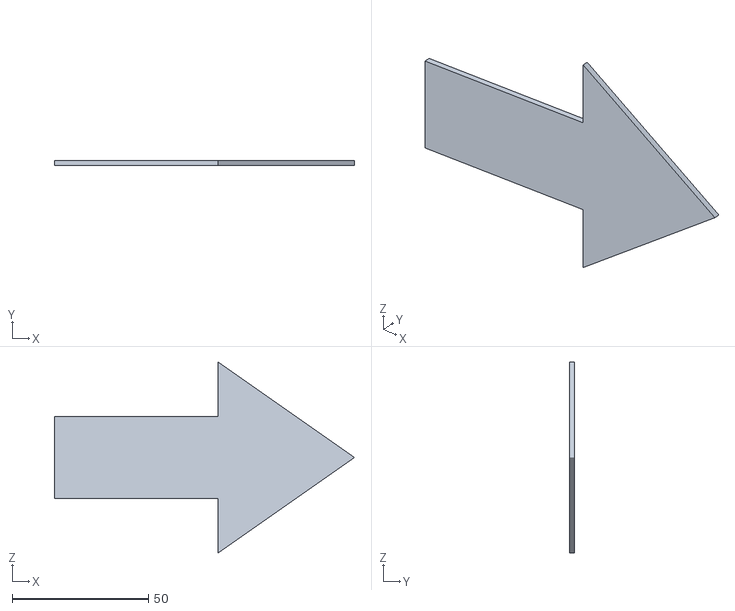
[picture p30: CAD file, 2026-10-28]
hardware/stl/Flecha media.stl
110.0 x 2.00 x 70.0
