franciscoNSoria/Competencia-Robotica-CAID/ros2_ws/src/caid_description/meshes/arm/arm_turret.stl

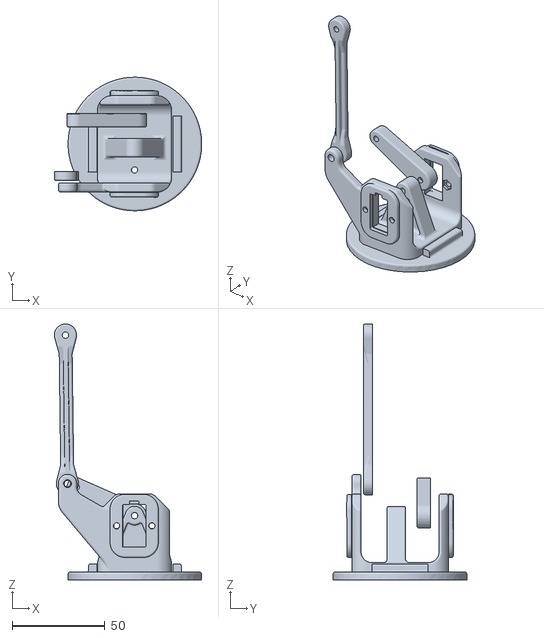
[picture p31: CAD file, 2026-10-19]
ros2_ws/src/caid_description/meshes/arm/arm_turret.stl
79.4 x 72.0 x 137.9
