franciscoNSoria/Competencia-Robotica-CAID/ros2_ws/src/caid_description/meshes/chasis_armadillo_inferior.stl

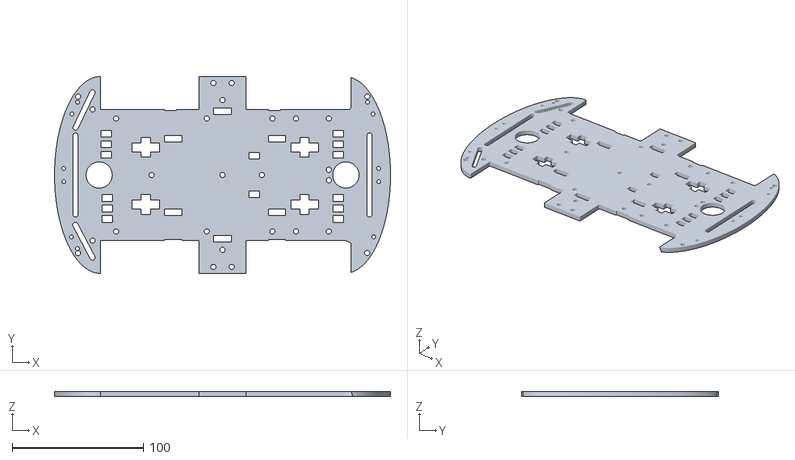
[picture p32: CAD file, 2026-10-19]
ros2_ws/src/caid_description/meshes/chasis_armadillo_inferior.stl
256.0 x 150.0 x 4.00
