franciscoNSoria/Competencia-Robotica-CAID/hardware/cad/Subconjunto-1-brazo/ARM2-CUDAR-0-1-90 Soporte triangular.SLDPRT

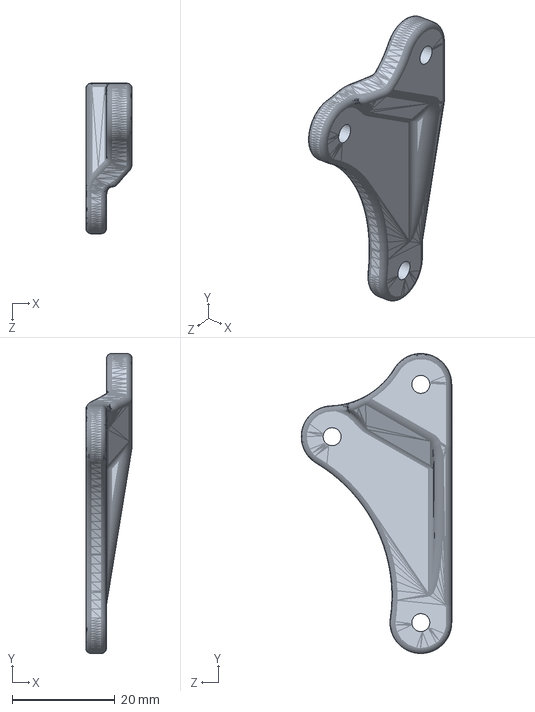
[picture p33: CAD file, 2026-10-15]
hardware/cad/Subconjunto-1-brazo/ARM2-CUDAR-0-1-90 Soporte triangular.SLDPRT
9.00 x 58.3 x 29.2 mm
