franciscoNSoria/Competencia-Robotica-CAID/hardware/cad/Subconjunto-3-camara/ARM2-CUDAR-0-3-30.SLDPRT

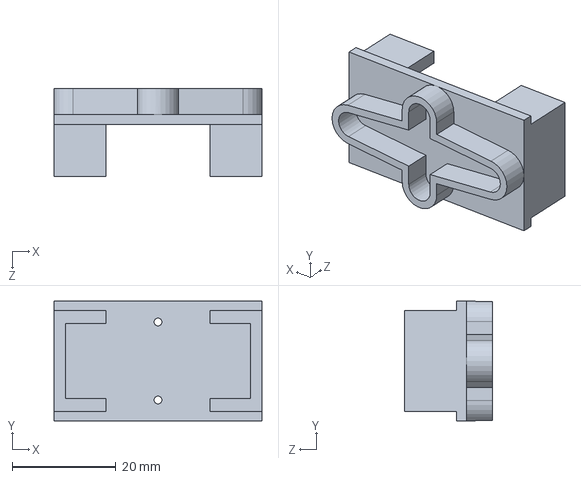
[picture p34: CAD file, 2026-10-15]
hardware/cad/Subconjunto-3-camara/ARM2-CUDAR-0-3-30.SLDPRT
40.0 x 23.0 x 17.0 mm
