franciscoNSoria/Competencia-Robotica-CAID/hardware/stl/Flecha Larga.stl

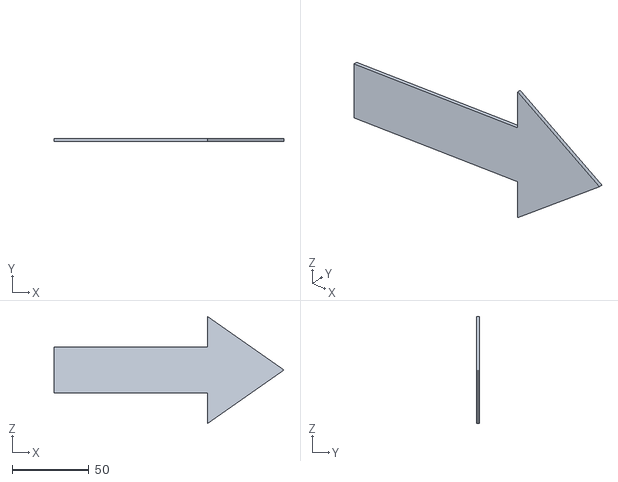
[picture p35: CAD file, 2026-10-28]
hardware/stl/Flecha Larga.stl
150.0 x 2.00 x 70.0
