franciscoNSoria/Competencia-Robotica-CAID/ros2_ws/src/caid_description/meshes/arm/arm_forearm.stl

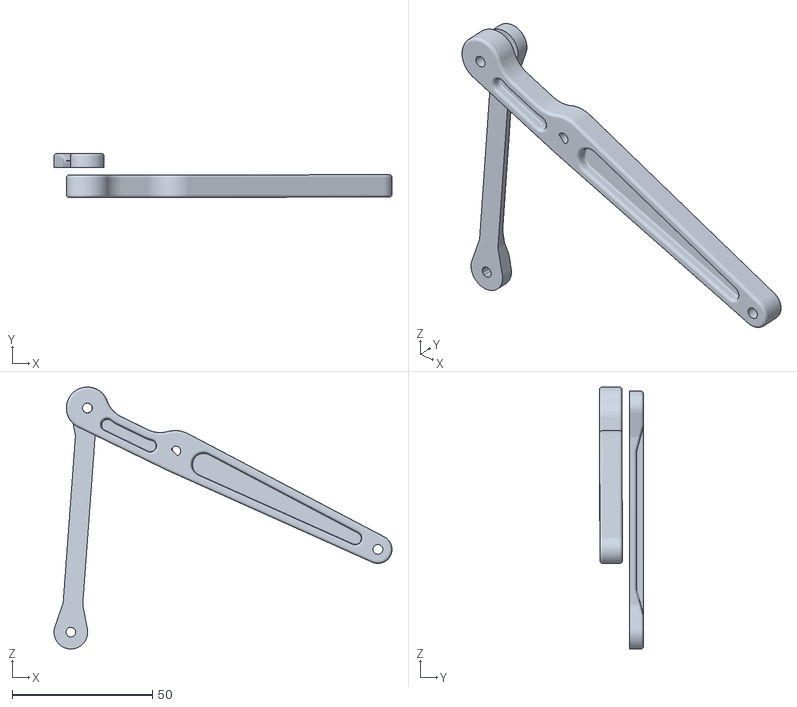
[picture p36: CAD file, 2026-10-19]
ros2_ws/src/caid_description/meshes/arm/arm_forearm.stl
120.3 x 15.7 x 93.3
