franciscoNSoria/Competencia-Robotica-CAID/hardware/cad/Subconjunto-1-brazo/ARM2-CUDAR-0-1-50 Garra izquierda.SLDPRT

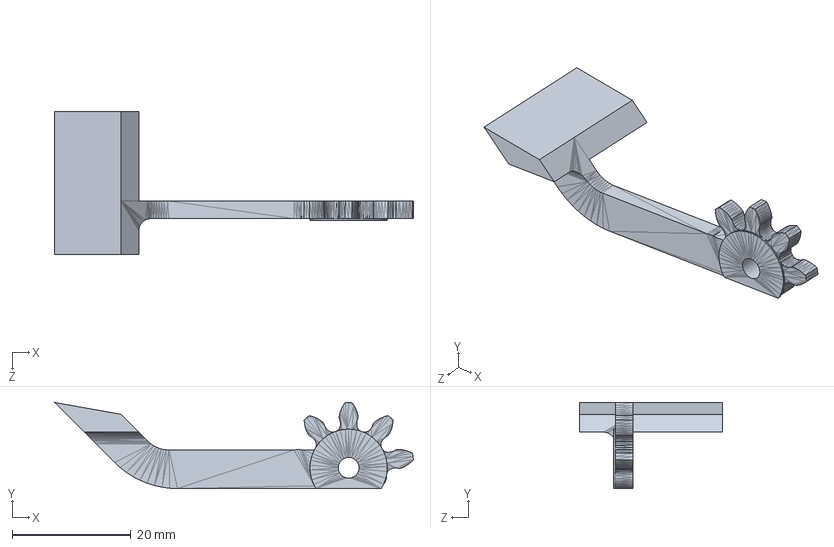
[picture p37: CAD file, 2026-10-15]
hardware/cad/Subconjunto-1-brazo/ARM2-CUDAR-0-1-50 Garra izquierda.SLDPRT
60.4 x 14.5 x 24.0 mm
