franciscoNSoria/Competencia-Robotica-CAID/hardware/cad/Subconjunto-2-chasis/ARM2-CUDAR-0-2-40.SLDPRT

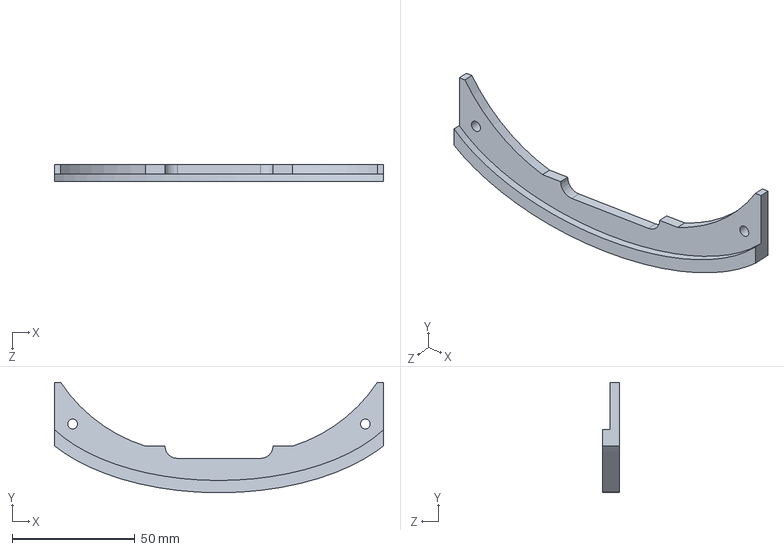
[picture p38: CAD file, 2026-10-15]
hardware/cad/Subconjunto-2-chasis/ARM2-CUDAR-0-2-40.SLDPRT
134.0 x 45.0 x 7.00 mm
