franciscoNSoria/Competencia-Robotica-CAID/hardware/cad/Subconjunto-3-camara/ARM2-CUDAR-0-3-20.SLDPRT

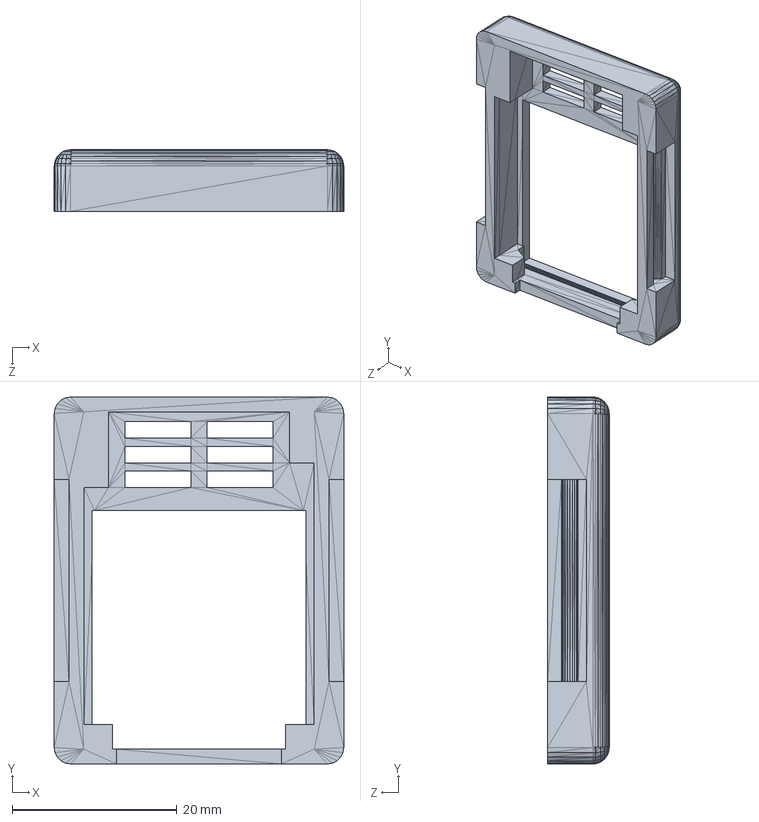
[picture p39: CAD file, 2026-10-15]
hardware/cad/Subconjunto-3-camara/ARM2-CUDAR-0-3-20.SLDPRT
35.2 x 44.6 x 7.50 mm
