franciscoNSoria/Competencia-Robotica-CAID/hardware/stl/Flecha corta.stl

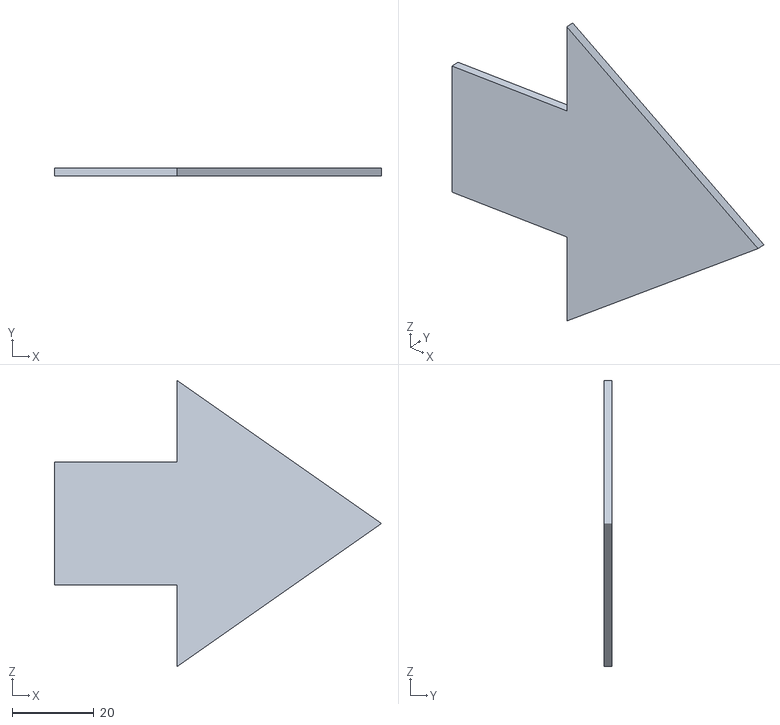
[picture p40: CAD file, 2026-10-28]
hardware/stl/Flecha corta.stl
80.0 x 2.00 x 70.0
