franciscoNSoria/Competencia-Robotica-CAID/ros2_ws/src/caid_description/meshes/arm/arm_claw_b.stl

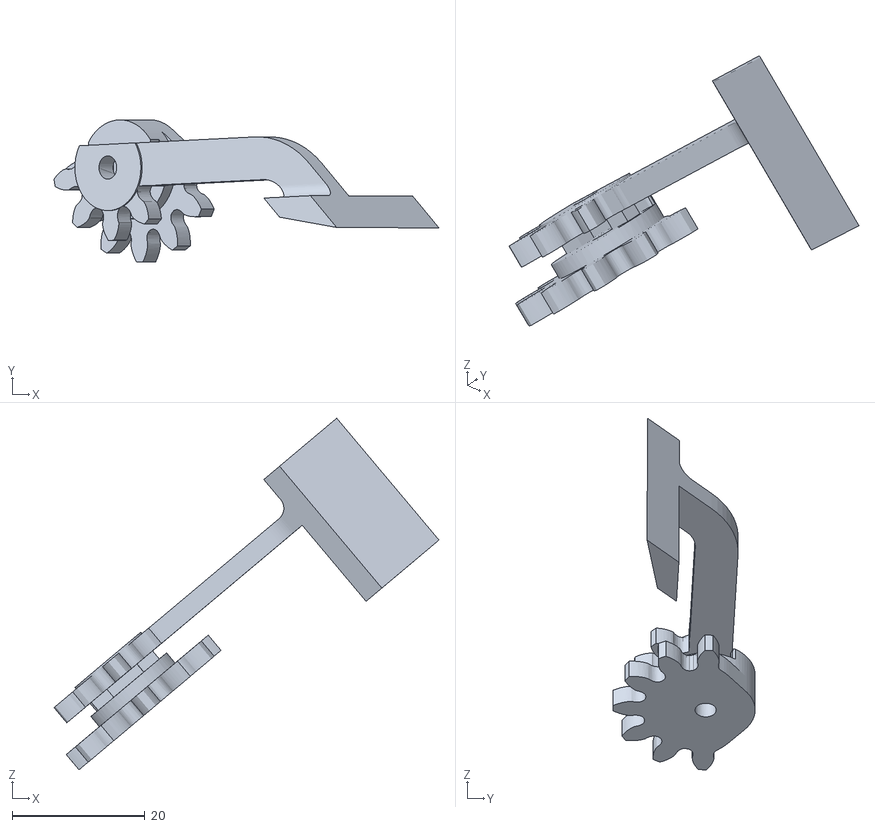
[picture p41: CAD file, 2026-10-19]
ros2_ws/src/caid_description/meshes/arm/arm_claw_b.stl
58.1 x 21.5 x 53.0
