franciscoNSoria/Competencia-Robotica-CAID/hardware/cad/Subconjunto-1-brazo/ARM2-CUDAR-0-1-110 Articulación.SLDPRT

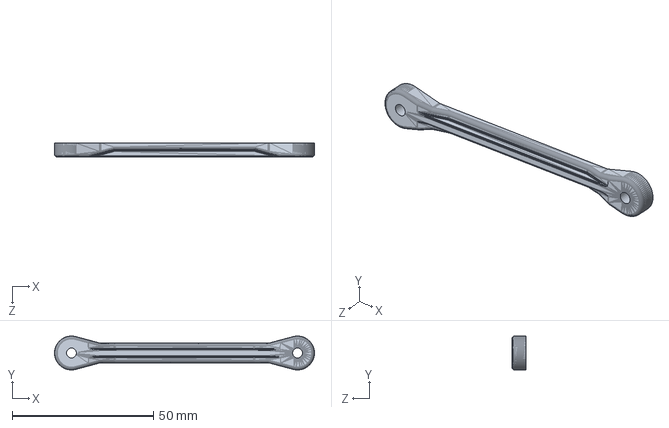
[picture p42: CAD file, 2026-10-15]
hardware/cad/Subconjunto-1-brazo/ARM2-CUDAR-0-1-110 Articulación.SLDPRT
92.0 x 12.0 x 5.00 mm
