franciscoNSoria/Competencia-Robotica-CAID/hardware/cad/Subconjunto-2-chasis/ARM2-CUDAR-0-2-60.SLDPRT

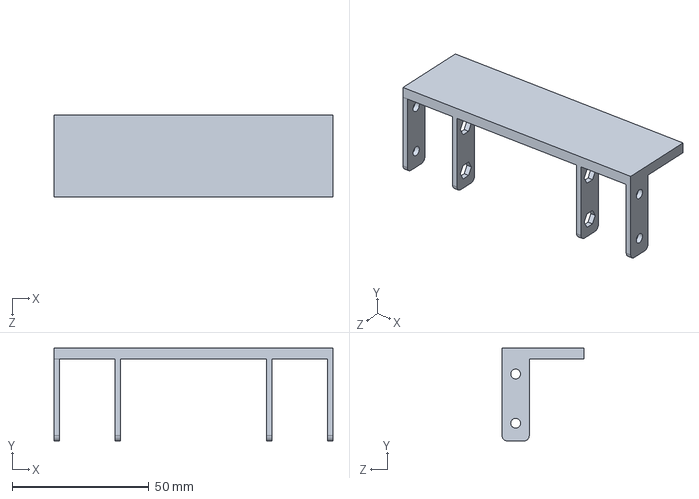
[picture p43: CAD file, 2026-10-15]
hardware/cad/Subconjunto-2-chasis/ARM2-CUDAR-0-2-60.SLDPRT
102.0 x 34.0 x 30.0 mm
