franciscoNSoria/Competencia-Robotica-CAID/hardware/stl/Canasto_Ficticio.stl

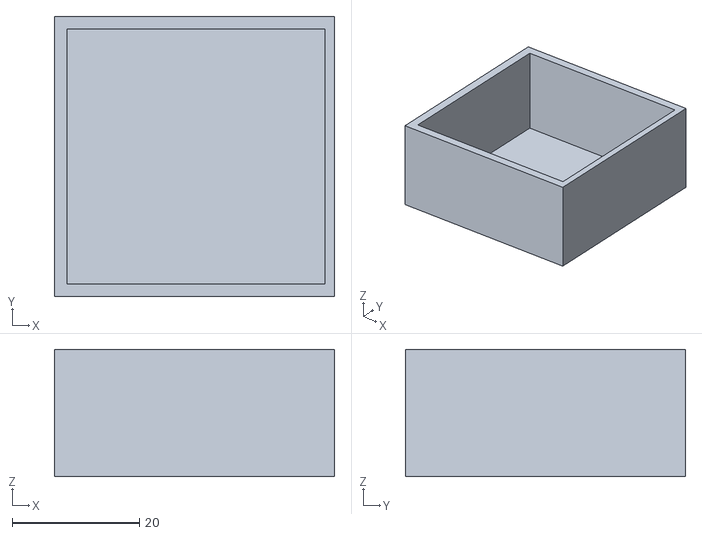
[picture p44: CAD file, 2026-10-28]
hardware/stl/Canasto_Ficticio.stl
44.0 x 44.0 x 20.0
