franciscoNSoria/Competencia-Robotica-CAID/ros2_ws/src/caid_description/meshes/arm/arm_claw_a.stl

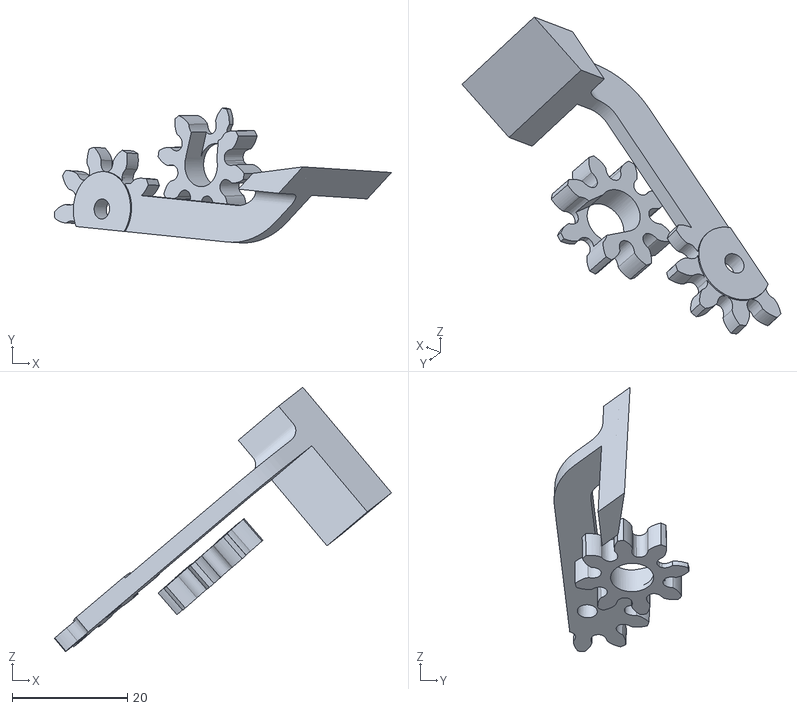
[picture p45: CAD file, 2026-10-19]
ros2_ws/src/caid_description/meshes/arm/arm_claw_a.stl
58.6 x 23.5 x 46.0
