franciscoNSoria/Competencia-Robotica-CAID/hardware/cad/Subconjunto-1-brazo/ARM2-CUDAR-0-1-20 Engranaje conductor.SLDPRT

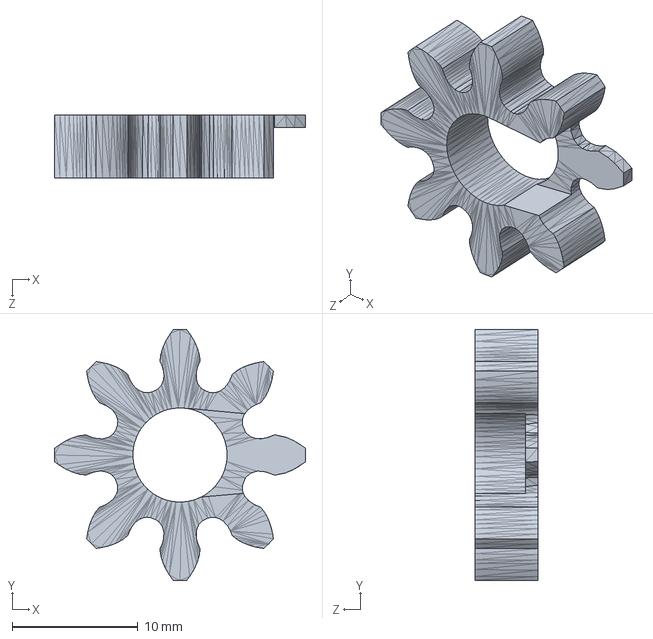
[picture p46: CAD file, 2026-10-15]
hardware/cad/Subconjunto-1-brazo/ARM2-CUDAR-0-1-20 Engranaje conductor.SLDPRT
20.0 x 20.0 x 5.00 mm
