franciscoNSoria/Competencia-Robotica-CAID/hardware/cad/Subconjunto-2-chasis/ARM2-CUDAR-0-2-30.SLDPRT

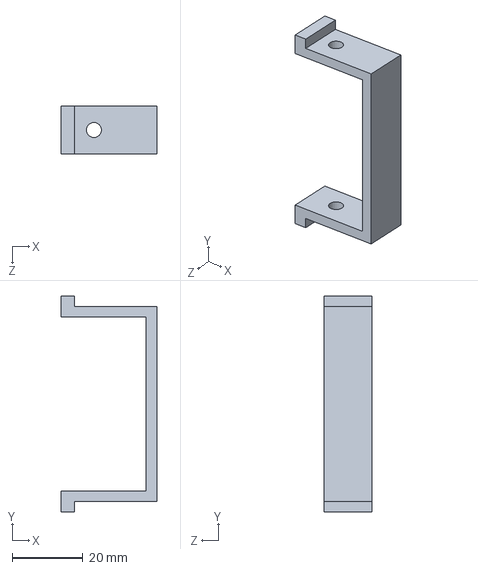
[picture p47: CAD file, 2026-10-15]
hardware/cad/Subconjunto-2-chasis/ARM2-CUDAR-0-2-30.SLDPRT
27.0 x 61.0 x 13.5 mm
