franciscoNSoria/Competencia-Robotica-CAID/ros2_ws/src/caid_description/meshes/arm/arm_base.stl

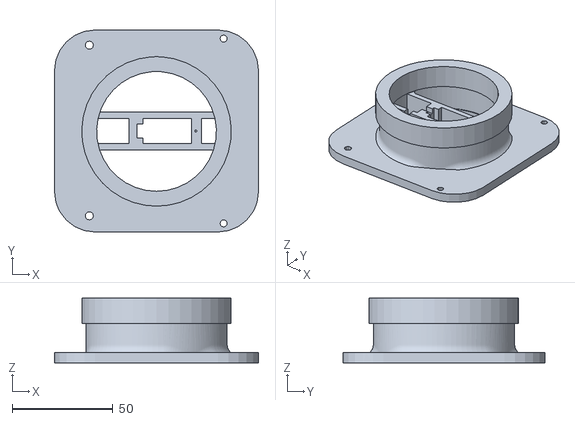
[picture p48: CAD file, 2026-10-19]
ros2_ws/src/caid_description/meshes/arm/arm_base.stl
101.0 x 100.0 x 32.0
