franciscoNSoria/Competencia-Robotica-CAID/hardware/cad/Subconjunto-1-brazo/ARM2-CUDAR-0-1-60 Garra derecha.SLDPRT

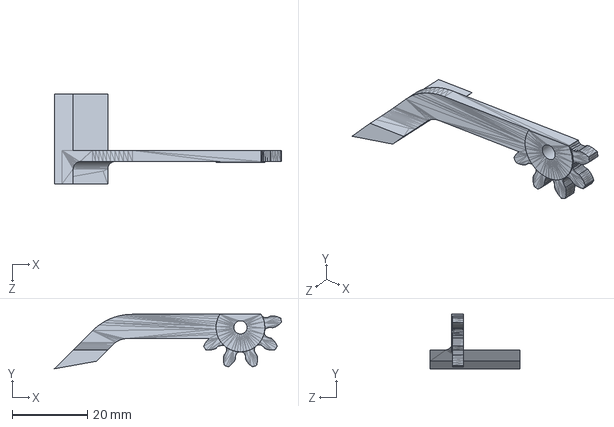
[picture p49: CAD file, 2026-10-15]
hardware/cad/Subconjunto-1-brazo/ARM2-CUDAR-0-1-60 Garra derecha.SLDPRT
60.4 x 14.5 x 24.0 mm
