franciscoNSoria/Competencia-Robotica-CAID/hardware/stl/ARM2-CUDAR-0-2-50_trasera-inferior.stl

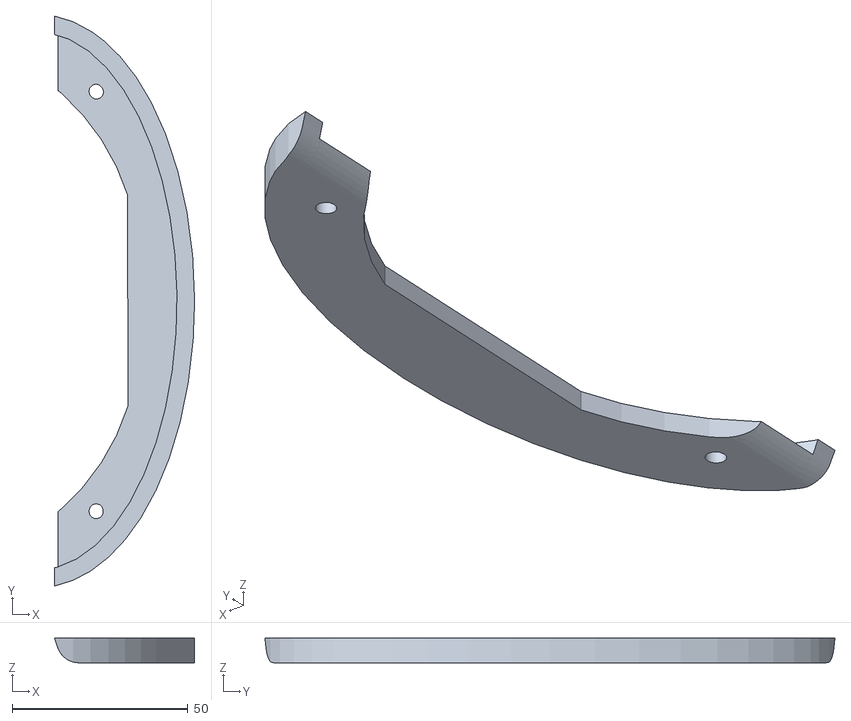
[picture p50: CAD file, 2026-10-19]
hardware/stl/ARM2-CUDAR-0-2-50_trasera-inferior.stl
39.8 x 161.9 x 7.00
