franciscoNSoria/Competencia-Robotica-CAID/ros2_ws/src/caid_description/meshes/arm/arm_upper.stl

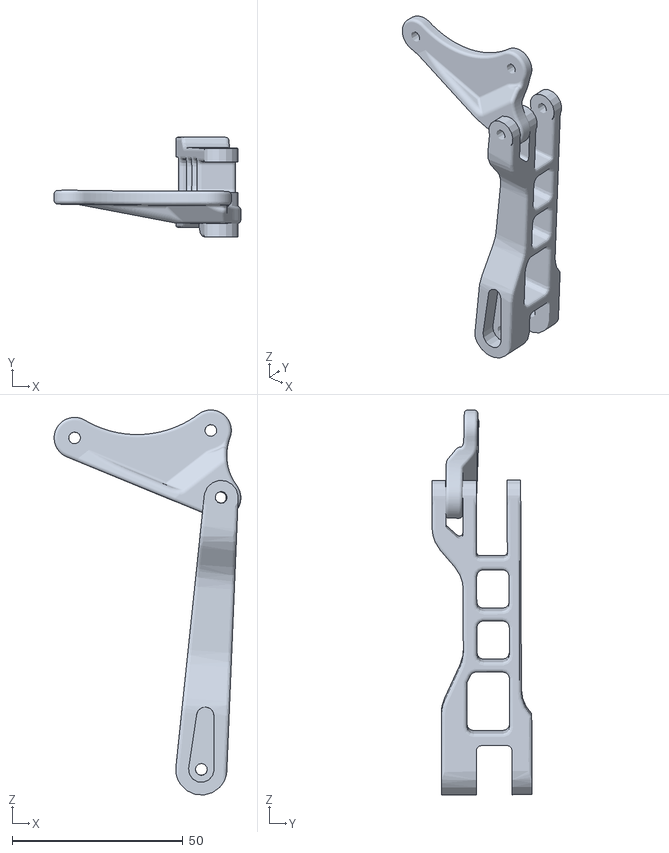
[picture p51: CAD file, 2026-10-19]
ros2_ws/src/caid_description/meshes/arm/arm_upper.stl
54.7 x 29.3 x 112.9
