franciscoNSoria/Competencia-Robotica-CAID/hardware/cad/Subconjunto-1-brazo/ARM2-CUDAR-0-1-30 Soporte de garras.SLDPRT

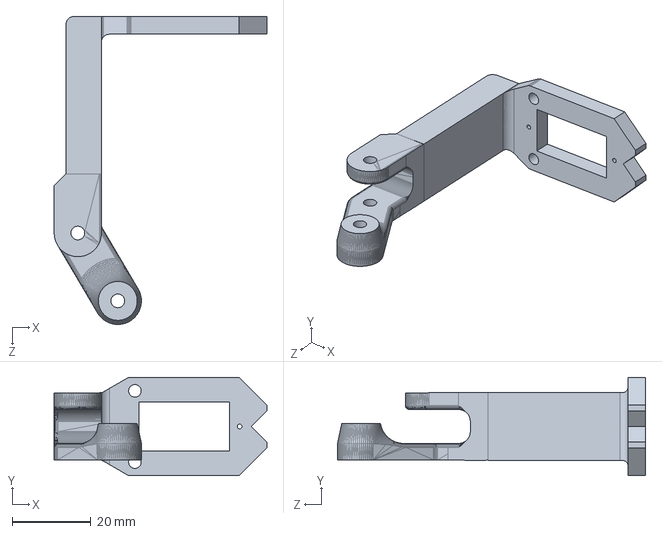
[picture p52: CAD file, 2026-10-15]
hardware/cad/Subconjunto-1-brazo/ARM2-CUDAR-0-1-30 Soporte de garras.SLDPRT
54.0 x 25.0 x 78.2 mm
