franciscoNSoria/Competencia-Robotica-CAID/hardware/cad/Subconjunto-1-brazo/ARM2-CUDAR-0-1-120 Soporte principal.SLDPRT

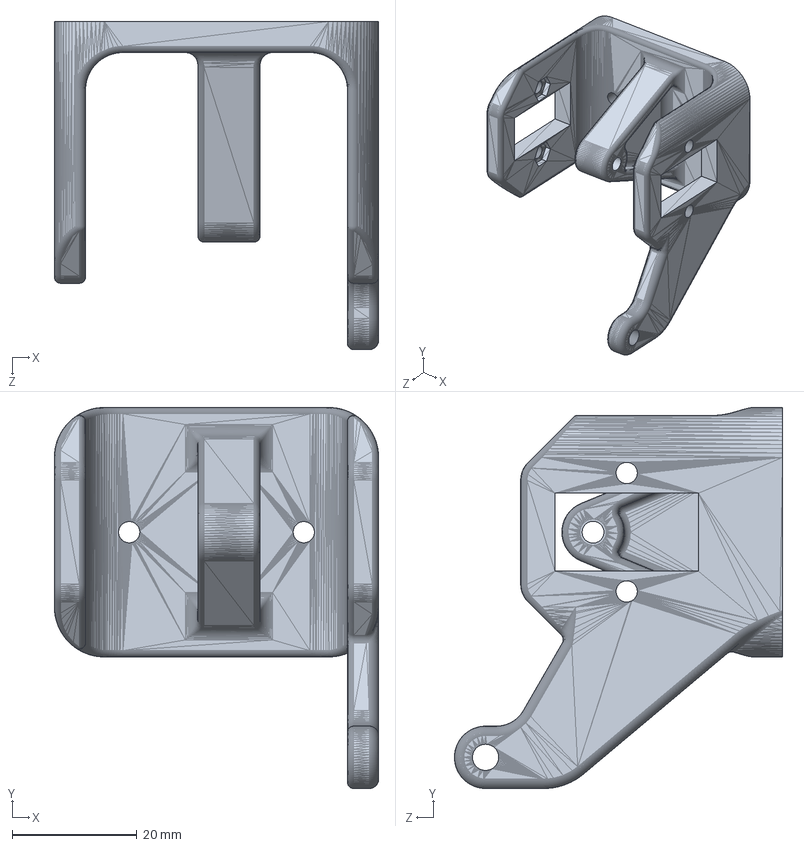
[picture p53: CAD file, 2026-10-15]
hardware/cad/Subconjunto-1-brazo/ARM2-CUDAR-0-1-120 Soporte principal.SLDPRT
52.0 x 61.1 x 52.6 mm
