franciscoNSoria/Competencia-Robotica-CAID/hardware/cad/Subconjunto-1-brazo/ARM2-CUDAR-0-1-40 Engranaje conducido.SLDPRT

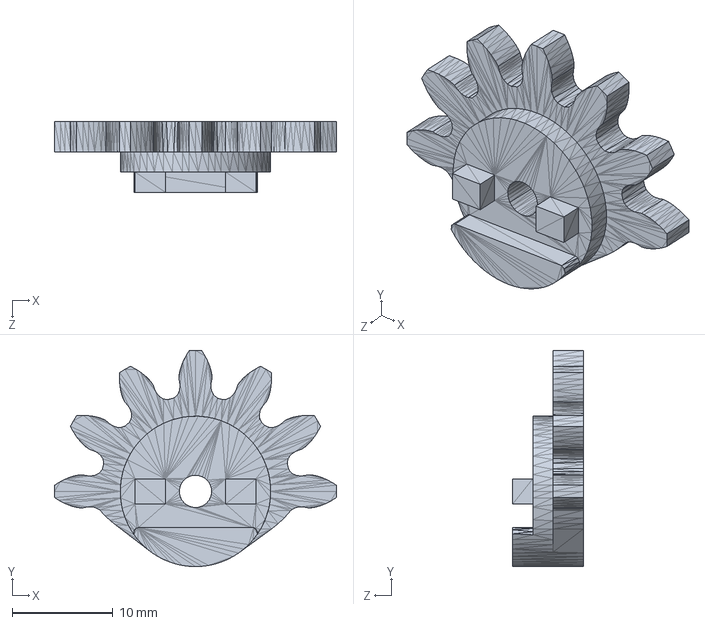
[picture p54: CAD file, 2026-10-15]
hardware/cad/Subconjunto-1-brazo/ARM2-CUDAR-0-1-40 Engranaje conducido.SLDPRT
28.0 x 21.5 x 7.00 mm
