franciscoNSoria/Competencia-Robotica-CAID/hardware/cad/Subconjunto-1-brazo/ARM2-CUDAR-0-1-150 Arandela de separacion.SLDPRT

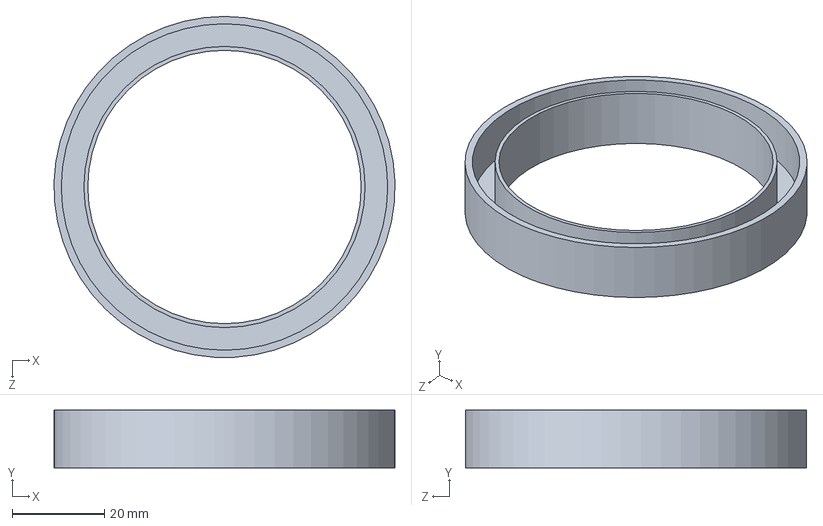
[picture p55: CAD file, 2026-10-15]
hardware/cad/Subconjunto-1-brazo/ARM2-CUDAR-0-1-150 Arandela de separacion.SLDPRT
74.0 x 12.5 x 74.0 mm
