franciscoNSoria/Competencia-Robotica-CAID/hardware/stl/ARM2-CUDAR-0-1-100 Brazo Superior.STL

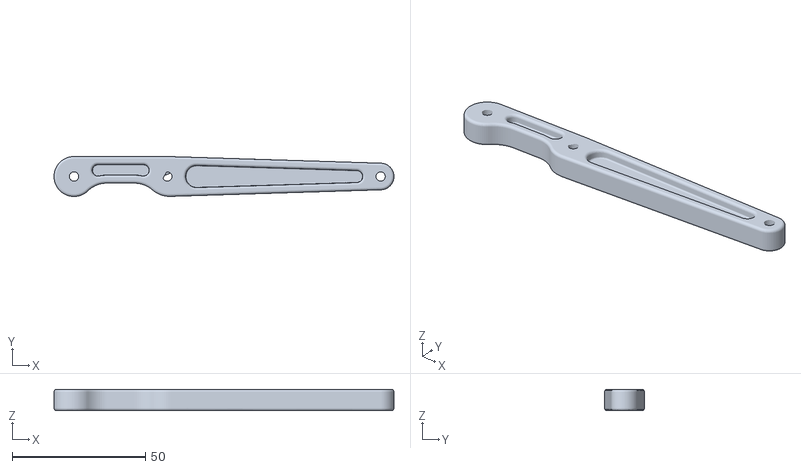
[picture p56: CAD file, 2026-10-15]
hardware/stl/ARM2-CUDAR-0-1-100 Brazo Superior.STL
127.5 x 15.0 x 8.00
