franciscoNSoria/Competencia-Robotica-CAID/hardware/cad/Subconjunto-1-brazo/ARM2-CUDAR-0-1-10 Base.SLDPRT

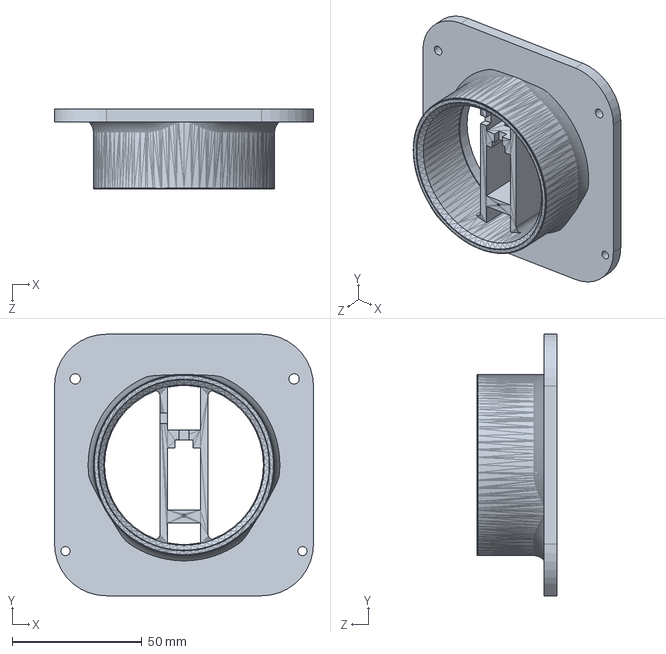
[picture p57: CAD file, 2026-10-15]
hardware/cad/Subconjunto-1-brazo/ARM2-CUDAR-0-1-10 Base.SLDPRT
100.0 x 101.0 x 31.0 mm
