franciscoNSoria/Competencia-Robotica-CAID/hardware/cad/Subconjunto-1-brazo/ARM2-CUDAR-0-1-70 Brazo para servo.SLDPRT

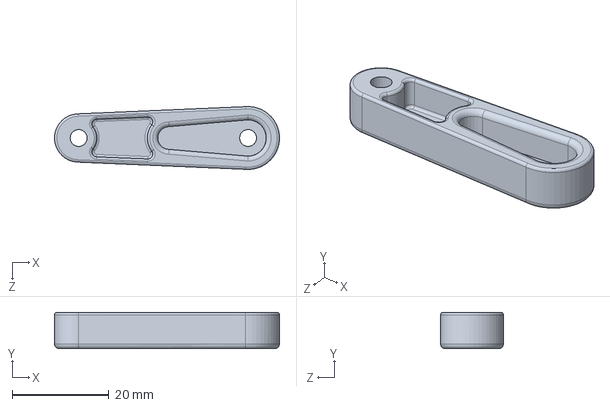
[picture p58: CAD file, 2026-10-15]
hardware/cad/Subconjunto-1-brazo/ARM2-CUDAR-0-1-70 Brazo para servo.SLDPRT
46.5 x 7.50 x 13.0 mm
