franciscoNSoria/Competencia-Robotica-CAID/hardware/cad/Subconjunto-1-brazo/ARM2-CUDAR-0-1-130 Plato circular.SLDPRT

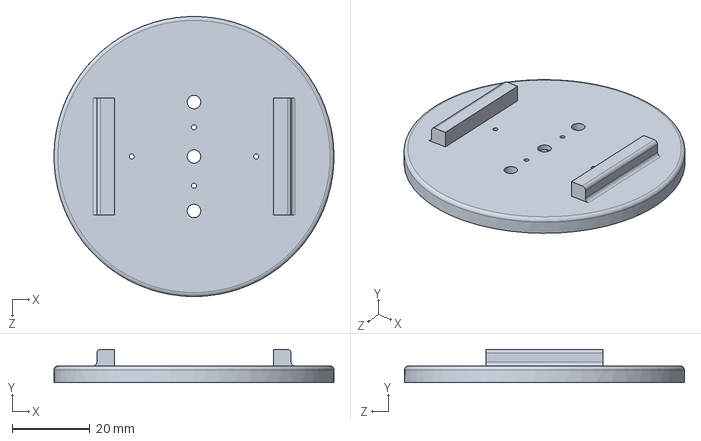
[picture p59: CAD file, 2026-10-15]
hardware/cad/Subconjunto-1-brazo/ARM2-CUDAR-0-1-130 Plato circular.SLDPRT
72.0 x 8.60 x 72.0 mm
