franciscoNSoria/Competencia-Robotica-CAID/hardware/stl/Cubo.STL

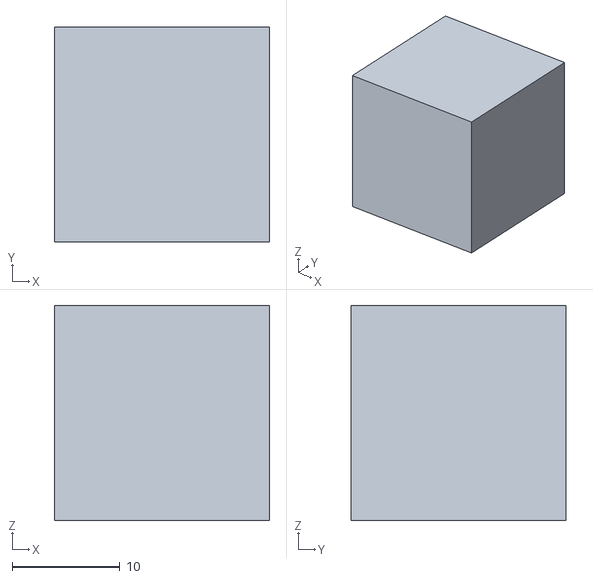
[picture p60: CAD file, 2026-10-15]
hardware/stl/Cubo.STL
20.0 x 20.0 x 20.0
