franciscoNSoria/Competencia-Robotica-CAID/(list of files, cad)

Other CAD files:
hardware/cad/Subconjunto-2-chasis/ARM2-CUDAR-0-2-20.SLDPRT
ros2_ws/src/caid_description/meshes/chasis_armadillo.stl
ros2_ws/src/caid_description/meshes/pared_frente.stl
hardware/stl/ARM2-CUDAR-0-3-30.STL
hardware/stl/ARM2-CUDAR-0-3-10.STL
hardware/stl/ARM2-CUDAR-0-1-140 Brazo principal.STL
hardware/stl/ARM2-CUDAR-0-3-40.STL
hardware/stl/ARM2-CUDAR-0-1-70 Brazo para servo.STL
hardware/cad/Subconjunto-1-brazo/ARM2-CUDAR-0-1-100 Brazo Superior.SLDPRT
hardware/stl/ARM2-CUDAR-0-2-60.STL
hardware/stl/ARM2-CUDAR-0-3-20.STL
hardware/stl/ARM2-CUDAR-0-1-90 Soporte triangular.STL
hardware/stl/ARM2-CUDAR-0-1-120 Soporte principal.STL
hardware/stl/ARM2-CUDAR-0-1-80 Soporte de servo.STL
hardware/stl/ARM2-CUDAR-0-1-20 Engranaje conductor.STL
hardware/stl/ARM2-CUDAR-0-2-40.STL
hardware/stl/ARM2-CUDAR-0-1-110 Articulación.STL
hardware/stl/ARM2-CUDAR-0-1-10 Base.STL
hardware/stl/ARM2-CUDAR-0-2-50.STL
hardware/stl/ARM2-CUDAR-0-1-40 Engranaje conducido.STL
hardware/stl/ARM2-CUDAR-0-2-30.STL
hardware/stl/ARM2-CUDAR-0-1-60 Garra derecha.STL
hardware/stl/ARM2-CUDAR-0-1-150 Arandela de separacion.STL
hardware/stl/ARM2-CUDAR-0-1-30 Soporte de garras.STL
hardware/stl/ARM2-CUDAR-0-1-50 Garra izquierda.STL
hardware/stl/ARM2-CUDAR-0-1-130 Plato circular.STL
hardware/cad/Bloque_de_pared_Con_Flechas.f3d
