franciscoNSoria/Competencia-Robotica-CAID/docs/arquitectura/img/arbol-tf.pdf

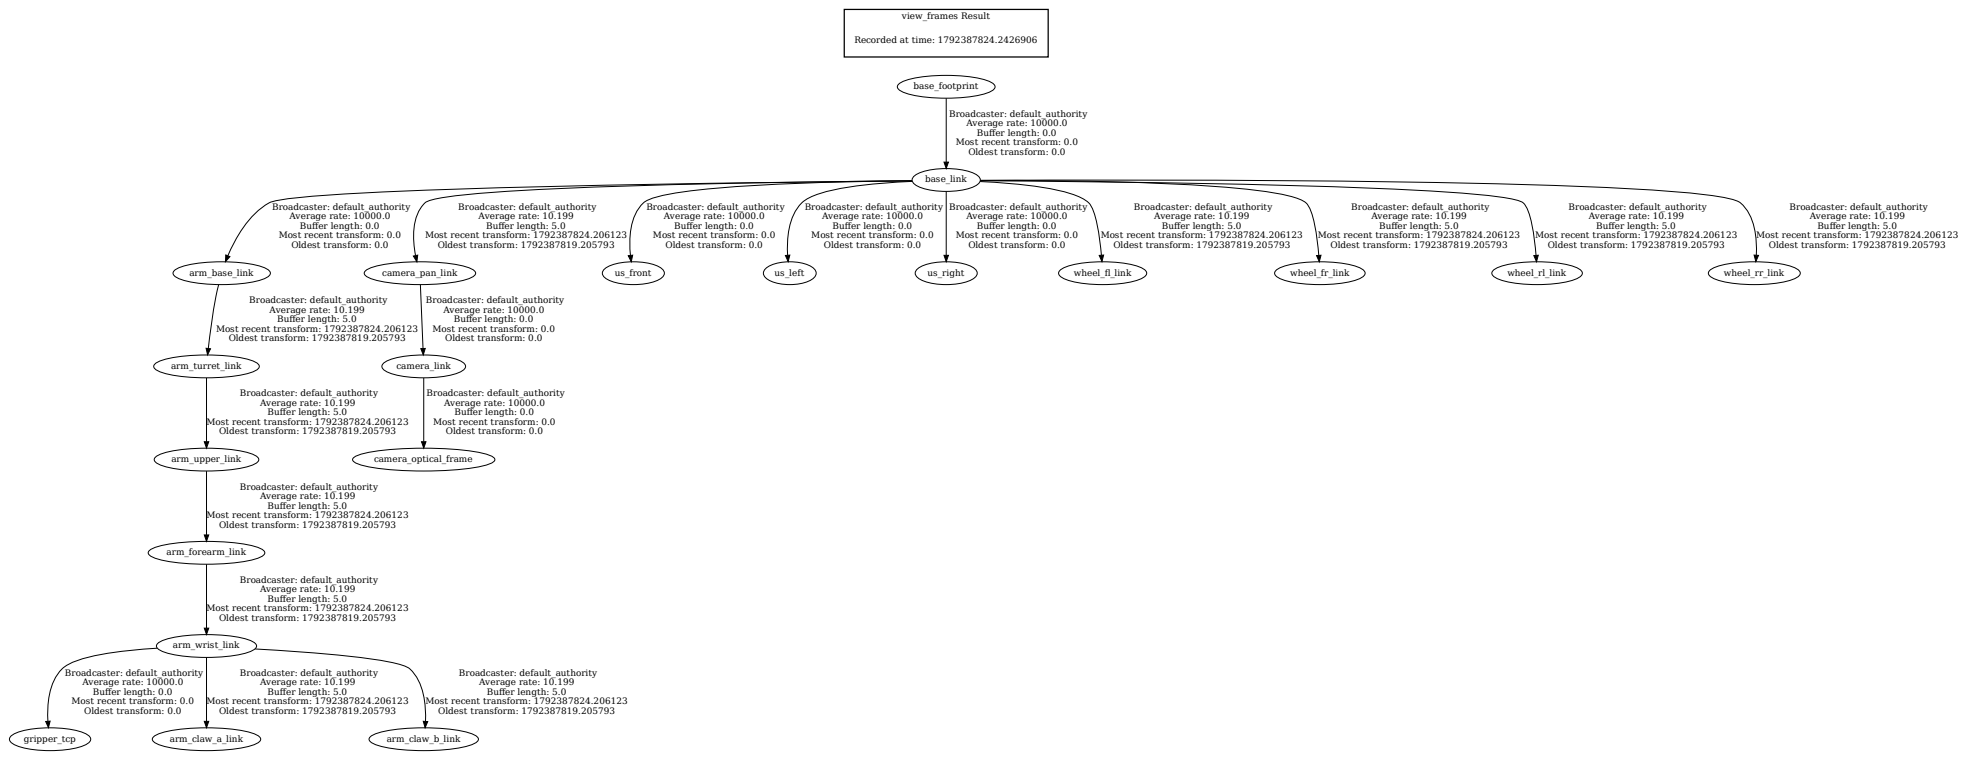
[picture p62: page 1]
view_frames Result; base_link; arm_base_link; camera_pan_link; Broadcaster: default_authority Average rate: 10.199 Buffer length: 5.0; us_front; us_left; us_right; wheel_fl_link; wheel_fr_link; wheel_rl_link; wheel_rr_link; arm_turret_link; base_footprint; camera_link; camera_optical_frame; arm_wrist_link; gripper_tcp; arm_claw_a_link; arm_claw_b_link; arm_forearm_link; arm_upper_link

Recorded at time: 1792387824.2426906

Broadcaster: default_authority
Average rate: 10000.0
Buffer length: 0.0
Most recent transform: 0.0
Oldest transform: 0.0

Most recent transform: 1792387824.206123
Oldest transform: 1792387819.205793
