franciscoNSoria/Competencia-Robotica-CAID/ros2_ws/src/caid_gazebo/mazes/e2_bifurcaciones.yaml

nombre: 'E2 Bifurcaciones: el color de la flecha elige el camino'
descripcion: Arbol con dos bifurcaciones en T y ramas ciegas. En cada T hay una flecha por cubo, del color de ese cubo, apuntando al lado en que
  esta. Prueba la lectura del color y la decision por viaje.
celda_m: 0.32
alto_pared_m: 0.17
inicio_dir: E
canastos_pared: O
altura_flechas_mm: 115
altura_apoyo_cubo_mm: 108.5
altura_borde_canasto_mm: 108.5
significado_colores:
  rojo: [R]
  verde: [G]
  azul: [B]
  gris: []
mapa: |
  ###################
  ###################
  ######...R##.######
  ######.#.###.######
  #1.###.#.#....G####
  #2S....###.########
  #3.###.###.########
  ######.###.########
  ######.....########
  ##########...B#####
  ###################
flechas:
- celda: [2, 6]
  pared: N
  dir: E
  largo: 3
  color: rojo
- celda: [2, 8]
  pared: N
  dir: E
  largo: 1
  color: rojo
  inclinacion: 12
- celda: [4, 10]
  pared: N
  dir: E
  largo: 3
  color: verde
  inclinacion: -9
- celda: [4, 12]
  pared: S
  dir: E
  largo: 2
  color: verde
  inclinacion: 18
- celda: [5, 3]
  pared: N
  dir: E
  largo: 3
  color: azul
  desplaza_mm: -80
- celda: [5, 3]
  pared: N
  dir: E
  largo: 3
  color: verde
  desplaza_mm: 80
  altura_mm: 125.0
- celda: [5, 3]
  pared: N
  dir: E
  largo: 3
  color: rojo
  desplaza_mm: 80
  altura_mm: 45.0
- celda: [5, 6]
  pared: E
  dir: N
  largo: 3
  color: rojo
  desplaza_mm: -80
- celda: [5, 6]
  pared: E
  dir: S
  largo: 3
  color: azul
  desplaza_mm: 80
  altura_mm: 125.0
- celda: [5, 6]
  pared: E
  dir: S
  largo: 3
  color: verde
  desplaza_mm: 80
  altura_mm: 45.0
- celda: [8, 6]
  pared: S
  dir: E
  largo: 3
  color: azul
  desplaza_mm: -80
- celda: [8, 6]
  pared: S
  dir: E
  largo: 3
  color: verde
  desplaza_mm: 80
- celda: [8, 10]
  pared: E
  dir: N
  largo: 3
  color: verde
  desplaza_mm: -80
- celda: [8, 10]
  pared: E
  dir: S
  largo: 1
  color: azul
  desplaza_mm: 80
- celda: [9, 10]
  pared: S
  dir: E
  largo: 3
  color: azul
  inclinacion: 6
