franciscoNSoria/Competencia-Robotica-CAID/(commit log)

2026-10-15 chore: agregar estructura inicial del proyecto CAID
    [ARM2-CUDAR-0-1-10 Base.SLDPRT, ARM2-CUDAR-0-1-100 Brazo Superior.SLDPRT, ARM2-CUDAR-0-1-110 Articulación.SLDPRT, ARM2-CUDAR-0-1-120 Soporte principal.SLDPRT, ARM2-CUDAR-0-1-130 Plato circular.SLDPRT, ARM2-CUDAR-0-1-140 Brazo principal.SLDPRT, ARM2-CUDAR-0-1-150 Arandela de separacion.SLDPRT, ARM2-CUDAR-0-1-20 Engranaje conductor.SLDPRT]
2026-10-15 Agrega archivos STL
    [ARM2-CUDAR-0-1-10 Base.STL, ARM2-CUDAR-0-1-100 Brazo Superior.STL, ARM2-CUDAR-0-1-110 Articulación.STL, ARM2-CUDAR-0-1-120 Soporte principal.STL, ARM2-CUDAR-0-1-130 Plato circular.STL, ARM2-CUDAR-0-1-140 Brazo principal.STL, ARM2-CUDAR-0-1-150 Arandela de separacion.STL, ARM2-CUDAR-0-1-20 Engranaje conductor.STL]
2026-10-17 chore(hardware): mueve los STL originales a hardware/stl
    [ARM2-CUDAR-0-1-10 Base.STL, ARM2-CUDAR-0-1-100 Brazo Superior.STL, ARM2-CUDAR-0-1-110 Articulación.STL, ARM2-CUDAR-0-1-120 Soporte principal.STL, ARM2-CUDAR-0-1-130 Plato circular.STL, ARM2-CUDAR-0-1-140 Brazo principal.STL, ARM2-CUDAR-0-1-150 Arandela de separacion.STL, ARM2-CUDAR-0-1-20 Engranaje conductor.STL]
2026-10-17 docs(hardware): índice de STL con medidas
2026-10-17 docs(hardware): índice de STL con cantidades, pesos y paredes del chasis
2026-10-17 feat(description): El esqueleto del paquete caid_description
    [inertia.xacro]
2026-10-17 feat(description): chasis de dos pisos, paredes y 4 ruedas en caid_bot.urdf.xacro
    [caid_bot.urdf.xacro, chasis_armadillo.stl, pared_frente.stl, pared_posterior.stl]
2026-10-19 feat(description): display.launch.py y configuración de RViz
2026-10-19 chore(hardware): piezas modificadas y ensamblado de Fusion
    [ARM2-CUDAR-0-2-20.STL, ARM2-CUDAR-0-2-50_trasera-inferior.stl, Chasis_Armadillo_inferior.stl, Robot_armadillo_armado.stl]
2026-10-19 feat(description): cotas del ensamblado de Fusion y paredes sobresalientes
    [caid_bot.urdf.xacro]
2026-10-19 feat(description): sensores, cámara con giro y piezas modificadas del ensamblado
    [caid_bot.urdf.xacro, chasis_armadillo_inferior.stl, pared_posterior.stl]
2026-10-19 feat(description): brazo fijo extraído del ensamblado (arm:=fixed|none)
    [arm.xacro, brazo_ensamblado.stl, caid_bot.urdf.xacro]
2026-10-19 feat(description): brazo articulado (yaw, hombro, codo, muñeca virtual y garras) con mallas por eslabón
    [arm.xacro, arm_base.stl, arm_claw_a.stl, arm_claw_b.stl, arm_forearm.stl, arm_turret.stl, arm_upper.stl, arm_wrist.stl]
2026-10-19 chore(description): quita la malla única del brazo y su script, reemplazados por dividir_brazo.py
    [brazo_ensamblado.stl]
2026-10-19 test(description): pruebas del árbol de links y articulaciones del modelo
2026-10-20 feat(gazebo): paquete caid_gazebo con mundos de prueba
2026-10-20 feat(camara): nodo de camara webcam/ESP32-CAM, vision de cubos/flechas y launch (CAM-02)
2026-10-20 feat(sim): robot en el laberinto con tracción y bridge de cmd_vel
    [caid_bot.urdf.xacro, gazebo.xacro]
2026-10-20 fix(bringup): quitar install duplicado de launch
2026-10-20 feat(sim): sensor de distancia frontal y GUI que arranca despues del robot
    [gazebo.xacro]
2026-10-20 feat(sim): tres ultrasonidos simulados, nodo scan_to_range y cierre limpio del servidor
    [gazebo.xacro]
2026-10-20 feat(sim): camara simulada, servo de camara, estados de articulaciones y reloj
    [gazebo.xacro]
2026-10-20 feat(sim): separacion efectiva calibrada, limites de aceleracion, RViz en el launch y script de prueba de giro
    [gazebo.xacro]
2026-10-20 docs(simulacion): guia de uso y seccion 09 de la memoria
2026-10-21 Update lista de componentes
    Added details for the front concentrator board components, including sensors, headers, and resistors.
2026-10-24 docs(adr): 0002, la red de competencia es un módem de la organización
2026-10-24 docs(memoria): calibración del giro en la simulación
2026-10-24 docs(guias): teoría y lecciones del banco de pruebas
2026-10-27 feat(gazebo): generador de laberintos y 6 escenarios con cubos y canastos a 108,5 mm
2026-10-27 docs(pruebas): formato de laberintos y escenarios de simulación
2026-10-27 chore(hardware): STL y F3D del bloque de pared, las flechas y el canasto de prueba
    [Bloque de pared reglamentario.stl, Bloque_de_pared_Con_Flechas.f3d, Canasto_Ficticio.stl, Flecha Larga.stl, Flecha corta.stl, Flecha media.stl]
2026-10-29 docs(decisiones): ADR 0003, firmware de movimiento con ESP-IDF
2026-10-29 docs(guias): caracterización de motores, cableado, PID y comunicación del robot de 4 ruedas
2026-10-29 feat(firmware): programas de banco y firmware de 4 ruedas con PI y micro-ROS
2026-10-29 feat(tools): teclado y calibración de las 4 ruedas por micro-ROS
2026-10-29 docs(brazo): pruebas de servos, límites medidos y firmwares de banco
2026-10-29 docs(hardware): placas de Altium dibujadas pobladas y esquemáticos ampliados
2026-10-29 NAV: núcleo de navegación por celdas y simulador 2D (en curso)
    Planificador (celda, rumbo) con giros verificados contra la huella del robot,
    localización con paredes, barrido de obstáculos con ultrasonido, ubicación de
    flechas/cubos/canastos/zonas desde la cámara, política de misión y simulador 2D
    que usa gen_maze.py. Trabajo en curso: todavía falla en escenarios con obstáculos.
    Claude-Session: https://claude.ai/code/session_018wmkJhF49xivh9eGCMsWty
2026-10-29 NAV: giro con sobrepaso como barrido, exploración cerca del canasto, corte de reacomodos
    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
2026-10-29 NAV: mirar costados aunque no haya lugar para barrer
    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
2026-10-29 NAV/PER: nodos ROS (navegador, visión con /vision/detecciones, brazo simulado), launch de misión, render de cámara y pruebas
    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
2026-10-29 docs: arquitectura de navegación y ADR 0004 (sin Nav2 ni SLAM)
    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
2026-10-29 NAV: canasto vs cubo por geometría, penalidad de salas, estilo ament_flake8 y resultados en docs
    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
2026-10-29 NAV: pilares negros cilíndricos, rumbo por regresión, trabados, puntos de reingreso y teoría
    - gen_maze: pilares de cubos y distractores como cilindros negros; mundos regenerados.
    - Localización: rumbo por regresión del residuo (sirve con el control corrigiendo), compuerta
    de 0,2 rad, bordes validados con la distancia esperada a la pared.
    - Registro lateral: pared solo si la lectura coincide con el borde; quieto no vuelve a votar.
    - Vigilante de trabado (avance y giro) con aprendizaje: encarece, cierra pasos nuevos, marca
    giros imposibles; segunda oportunidad olvidando giros imposibles.
    - Pilar del cubo en el mapa siguiendo la estimación y en todas las celdas que toca.
    - parece_can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
2026-10-29 PER: forma_de_cubo acepta solo la razón de bordes de un cubo (descarta canastos y pedazos de flecha)
    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
2026-10-29 PER: forma_de_cubo con piso 0,24 (de cerca los cubos reales dan 0,27)
    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
2026-10-29 docs: resultados finales del 29/10, riesgos y filtro de forma de cubo en la teoría
    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
2026-10-30 pruebas: un firmware por componente (sonares, encoders, motores, servos, pan de la cámara) por micro-ROS
    - firmware/pruebas: 20 pruebas (00 enlace, 10-13 sonares, 20-23 encoders, 30-33 motores, 34 las 4 ruedas con
    verificación automática de cableado, 40-43 servos del brazo, 44 brazo coordinado con poses y secuencia de agarre
    lateral, 50 pan en la ESP32-CAM), base común con reconexión al agente, y compilar.sh.
    - tools/pruebas/prueba.py: herramienta de PC por teclado para todas las pruebas.
    - README con pines (servos en 18/19/21/22, pan en GPIO13 de la CAM), conexiones, terminales y qué mirar.
    Claude-Session: https://claude.ai/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
2026-10-30 pruebas: circuito completo del robot con el pinout actual (PNG)
    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
2026-11-03 brazo: v1 con sliders funcionando (antes de la v2)
2026-11-03 brazo v3: tope por servo, reposo seguro antes de girar la base y README
    Limites y reposo editables desde la ventana. La ESP32 retiene la base hasta que el hombro y el codo estan en el reposo seguro. Probado solo en simulacion en la PC; falta probarlo en el robot.
